YanOliveira00/Optical-Power-Meter/Photos/Tests and black box/02 Inside the box.jpg

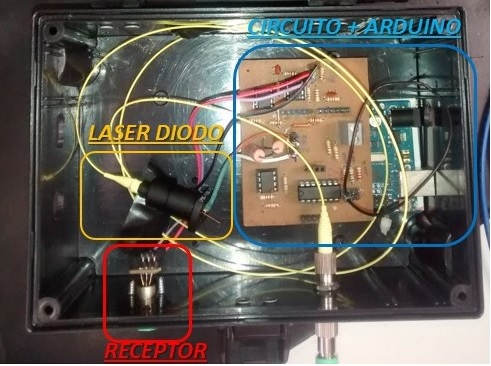
Photos/Tests and black box/02 Inside the box.jpg
