YanOliveira00/Optical-Power-Meter/Photos/Tests and black box/01 First test.jpg

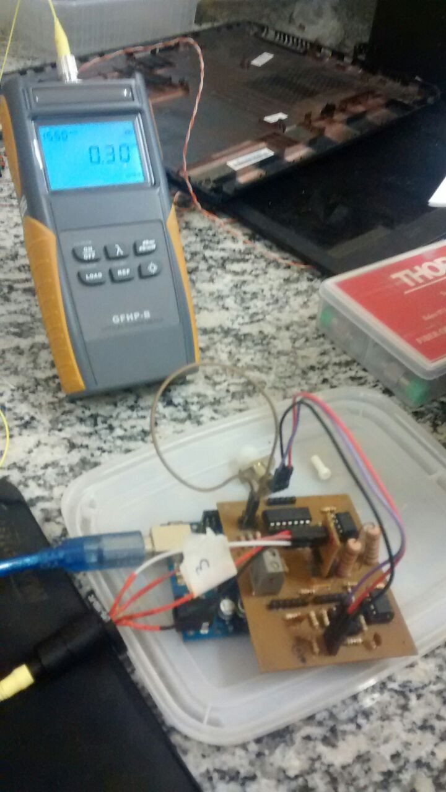
Photos/Tests and black box/01 First test.jpg
