YanOliveira00/Optical-Power-Meter/Photos/Graphics and presentation/Apresentação TCC - Yan Oliveira pdf.pdf

Universidade Federal do Pará Instituto de Tecnologia
Faculdade de Engenharia da Computação

## INTERROGADOR ÓPTICO DE BAIXO CUSTO PARA DETECÇÃO DE CURVATURA EM FIBRA ÓPTICA

Trabalho de Conclusão de Curso Orientado: Yan Sérgio de Oliveira – 201006840052 Orientador: Prof. Dr. Marco José de Sousa

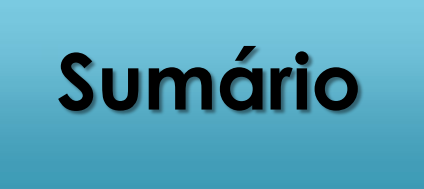
[picture p3: figure]
Sumário

1. Introdução ▪ | Monitoramento Estrutural ▪ | Sensores ópticos ▪ | Medidores ópticos ▪ | Solução proposta
2. O interrogador ▪ | Princípio operacional ▪ | Componentes externos

## 3. Circuitos

## 4. Software

## 5. Testes e resultados

## 6. Conclusões e trabalhos futuros

7. Referências.

2

# 1 – Introdução Monitoramento Estrutural (SHM – Structural Health Monitoring)

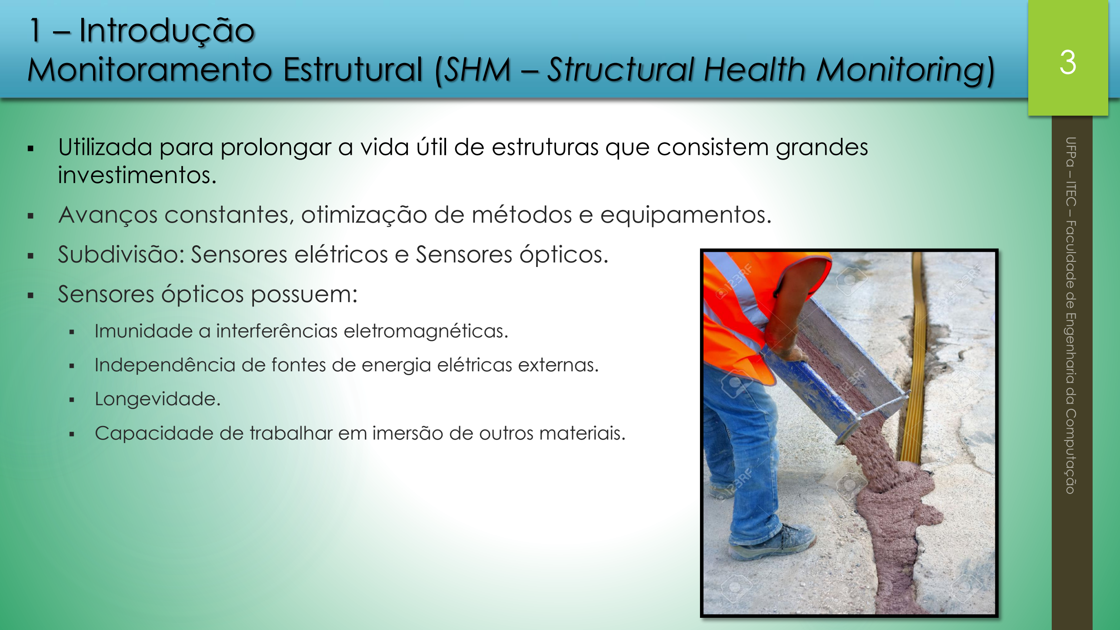
[picture p4: page 3]

## - Utilizada para prolongar a vida útil de estruturas que consistem grandes

investimentos.

- Avanços constantes, otimização de métodos e equipamentos.
- Subdivisão: Sensores elétricos e Sensores ópticos.

## - Sensores ópticos possuem:

- Imunidade a interferências eletromagnéticas.
- Independência de fontes de energia elétricas externas.
- Longevidade.
- Capacidade de trabalhar em imersão de outros materiais.

3

# 1 – Introdução Sensores Ópticos FBG (Fiber Bragg Grattings)

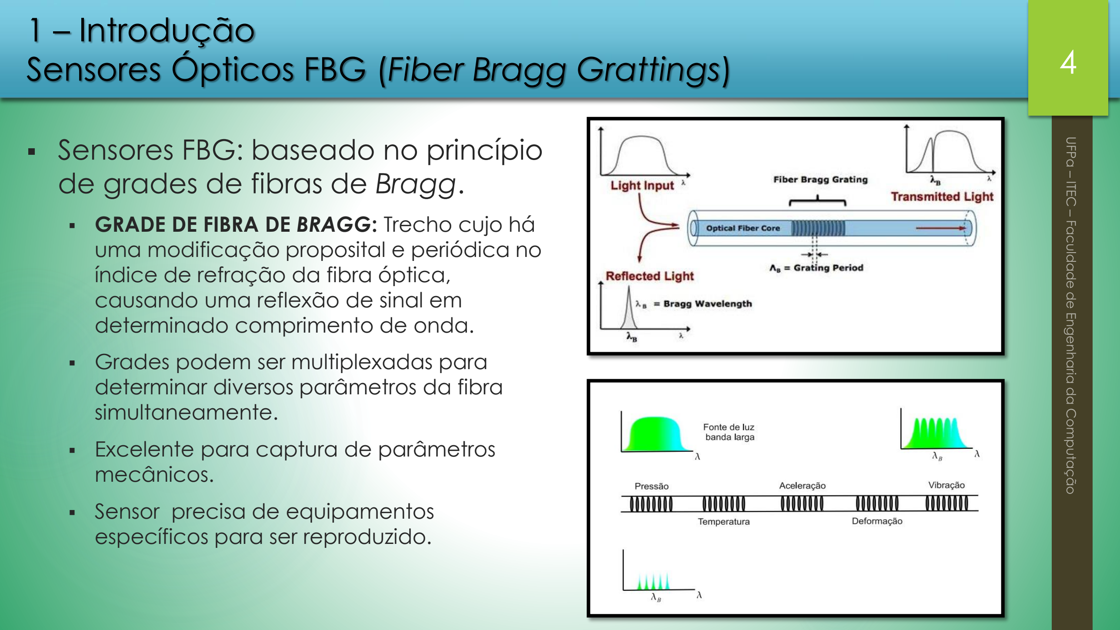
[picture p5: page 4]

## - Sensores FBG: baseado no princípio

de grades de fibras de Bragg.

- GRADE DE FIBRA DE BRAGG: Trecho cujo há uma modificação proposital e periódica no índice de refração da fibra óptica, causando uma reflexão de sinal em determinado comprimento de onda.
- Grades podem ser multiplexadas para

### determinar diversos parâmetros da fibra

simultaneamente.

- Excelente para captura de parâmetros mecânicos.

### - Sensor precisa de equipamentos

específicos para ser reproduzido.

4

# 1 – Introdução Sensores Ópticos FBG (Fiber Bragg Grattings)

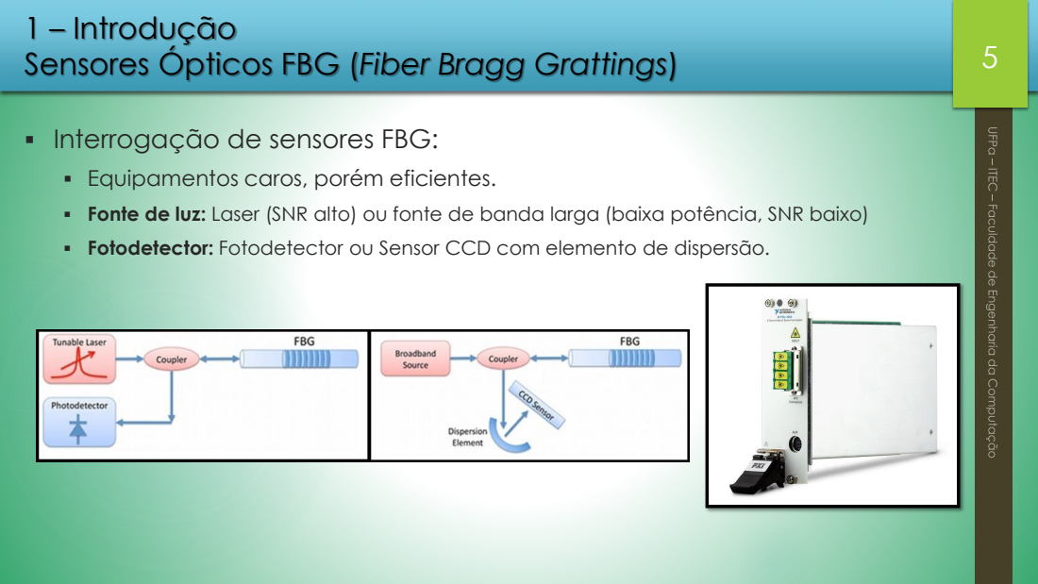
[picture p6: page 5]

▪ Interrogação de sensores FBG:

▪ Equipamentos caros, porém eficientes.

▪ Fonte de luz: Laser (SNR alto) ou fonte de banda larga (baixa potência, SNR baixo)
▪ Fotodetector: Fotodetector ou Sensor CCD com elemento de dispersão.

# 1 – Introdução Sensores SMS (Single-Multi-Single Mode)

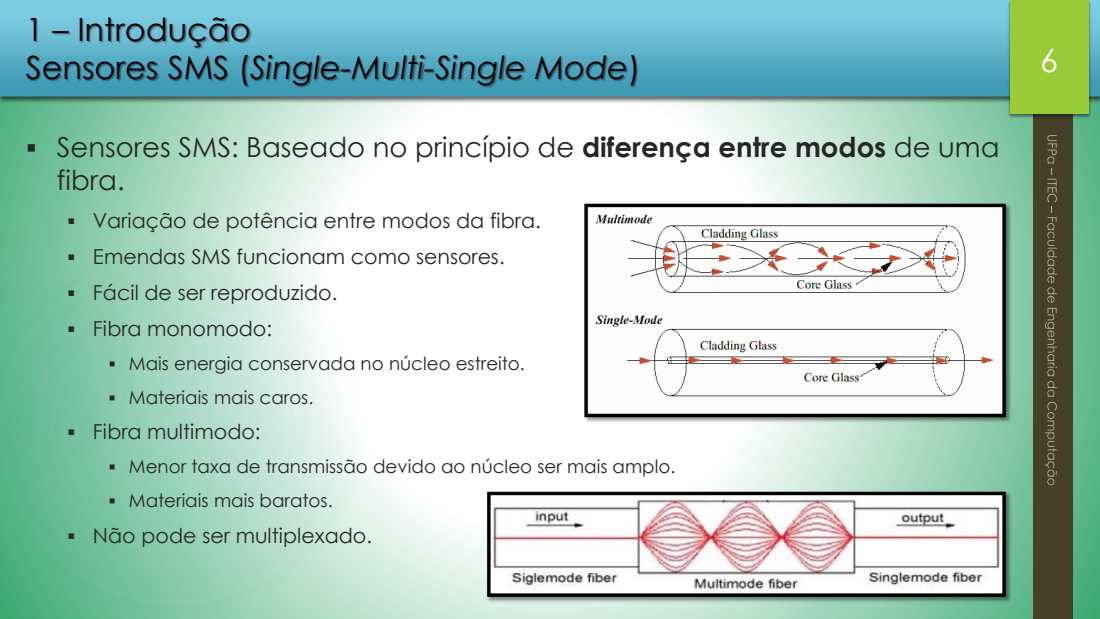
[picture p7: page 6]

▪ Sensores SMS: Baseado no princípio de diferença entre modos de uma
fibra.

▪ Variação de potência entre modos da fibra.
▪ Emendas SMS funcionam como sensores.
▪ Fácil de ser reproduzido.
▪ Fibra monomodo:

▪ Mais energia conservada no núcleo estreito.

▪ Materiais mais caros.
▪ Fibra multimodo:

▪ Menor taxa de transmissão devido ao núcleo ser mais amplo.

▪ Materiais mais baratos.
▪ Não pode ser multiplexado.

# 1 – Introdução Sensores SMS (Single-Multi-Single Mode)

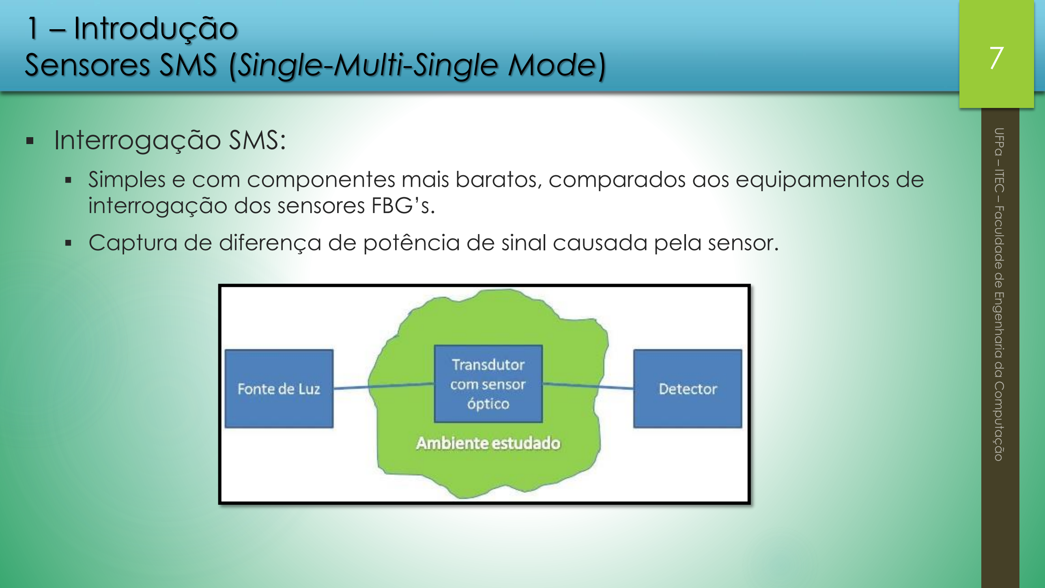
[picture p8: page 7]

## - Interrogação SMS:

## - Simples e com componentes mais baratos, comparados aos equipamentos de

interrogação dos sensores FBG’s.

- Captura de diferença de potência de sinal causada pela sensor.

7

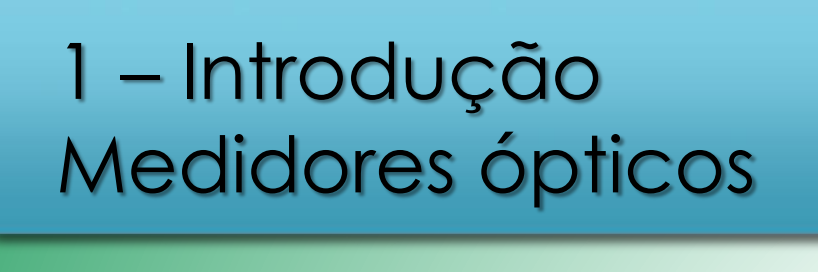
[picture p9: figure]
– Introdução

Medidores ópticos ▪ | OPM – Optical Power Meter: ▪ | Medidor de potência de sinal na fibra. ▪ | Fonte de luz ajustada a um certo nível de

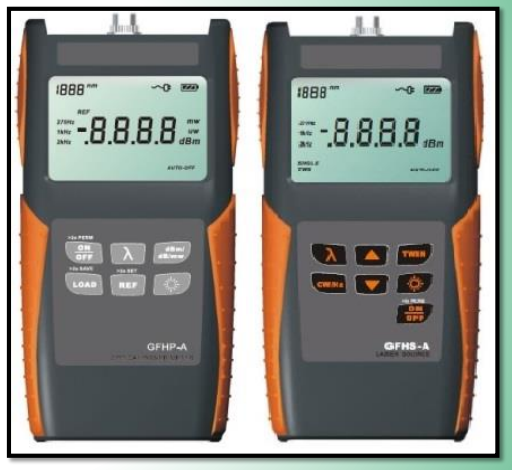
[picture p10: figure]

potência.

- | Detector com amplificador para medição ▪ | Display para visualização ▪ | Custa em torno de R$ 2.745,00. Pode sofrer

acréscimos nesse valor.

- | Podem possuir outras funções práticas: ▪ | Medidor de luminosidade. ▪ | Fotômetro.

8

1

# – Introdução

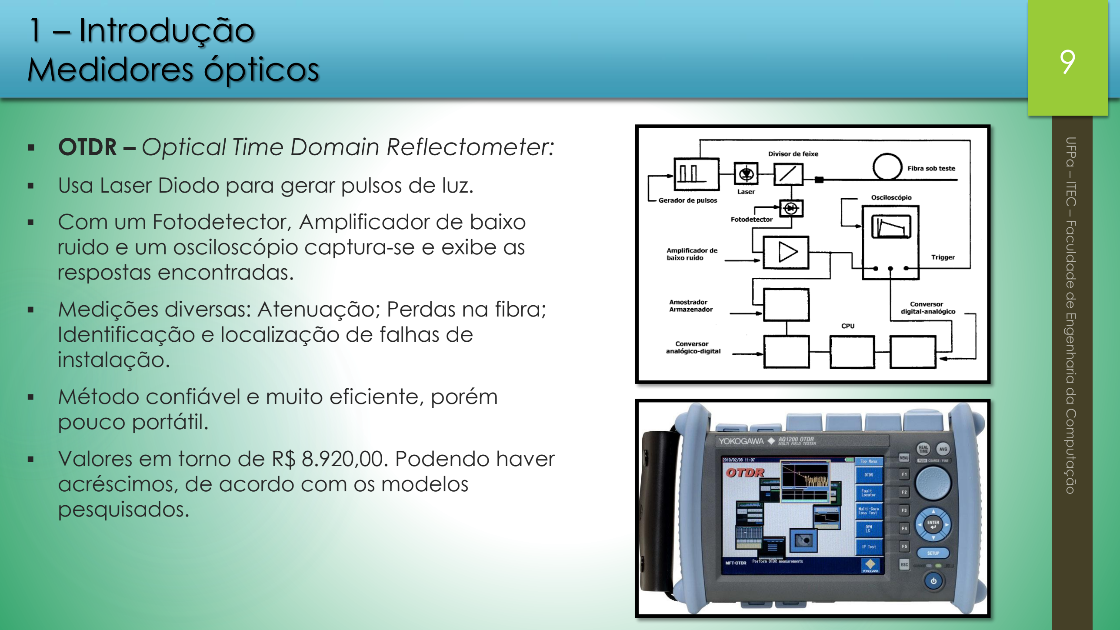
[picture p11: page 9]

## Medidores ópticos ▪ OTDR – Optical Time Domain Reflectometer

:

- Usa Laser Diodo para gerar pulsos de luz

- Com um Fotodetector, Amplificador de baixo ruido e um osciloscópio captura
-se e exibe as
respostas encontradas.
- Medições diversas: Atenuação; Perdas na fibra; Identificação e localização de falhas de instalação

### - Método confiável e muito eficiente, porém

pouco portátil
- Valores em torno de R$ 8.920,00. Podendo haver acréscimos, de acordo com os modelos

### pesquisados

9

# 1 – Introdução Proposta

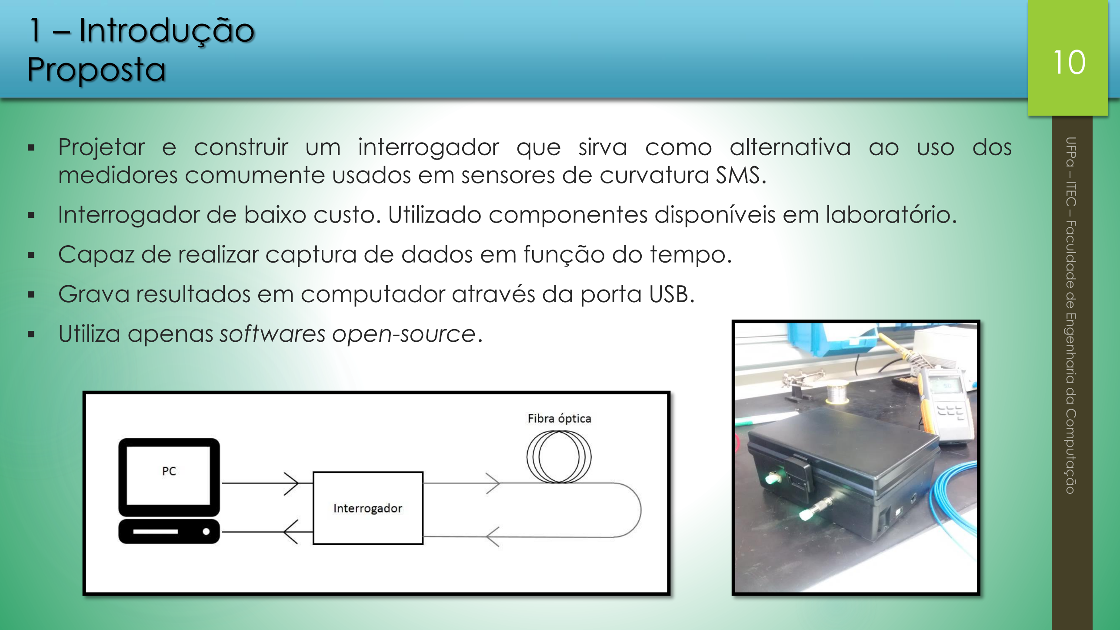
[picture p12: page 10]

## - Projetar e construir um interrogador que sirva como alternativa ao uso dos

medidores comumente usados em sensores de curvatura SMS.

- Interrogador de baixo custo. Utilizado componentes disponíveis em laboratório.
- Capaz de realizar captura de dados em função do tempo.
- Grava resultados em computador através da porta USB.
- Utiliza apenas softwares open-source.

10

# 2. O interrogador Princípio Operacional

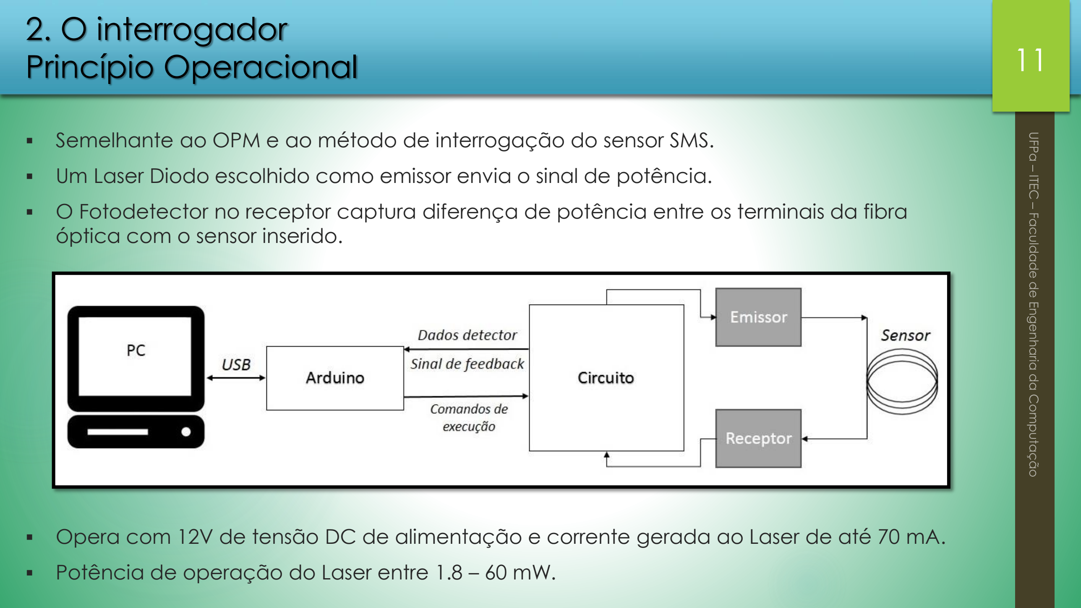
[picture p13: page 11]

- Semelhante ao OPM e ao método de interrogação do sensor SMS.
- Um Laser Diodo escolhido como emissor envia o sinal de potência.
- O Fotodetector no receptor captura diferença de potência entre os terminais da fibra óptica com o sensor inserido.
- Opera com 12V de tensão DC de alimentação e corrente gerada ao Laser de até 70 mA.
- Potência de operação do Laser entre 1.8 – 60 mW.

11

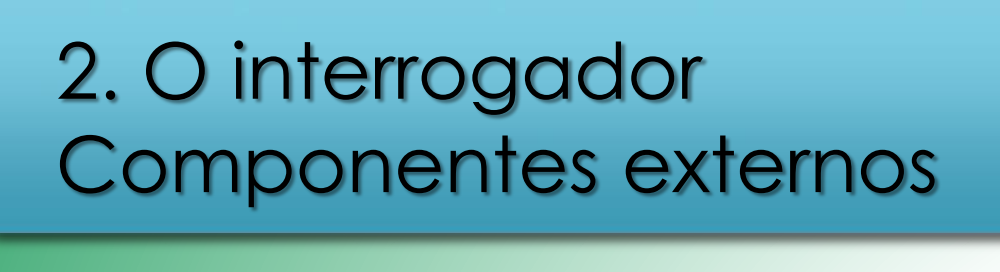
[picture p14: figure]
2. O interrogador Componentes externos

## - O interrogador é formado pelos seguintes componentes:

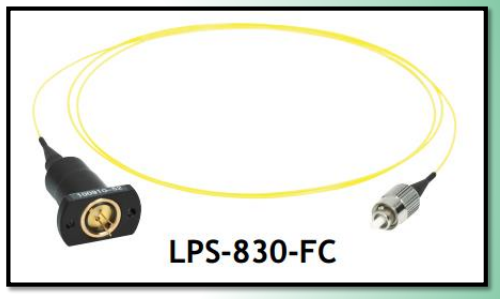
[picture p15: figure]

## - SBC ArduinoUno®

## - Laser Diodos:

- Modelos disponíveis: LP, LPM, LPS, LPSC.
- Comprimentos de onda: 660-1550 nm
- Potência Máxima: 60 mW

## - Fotodetector:

- Modelo: FGA01FC

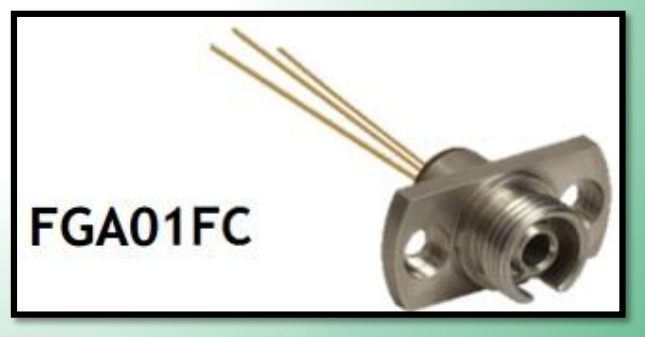
[picture p16: figure]

- Comprimentos de onda: 800-1770 nm

### - Potência Máxima: 18 mW

12

# 3. Circuitos

13

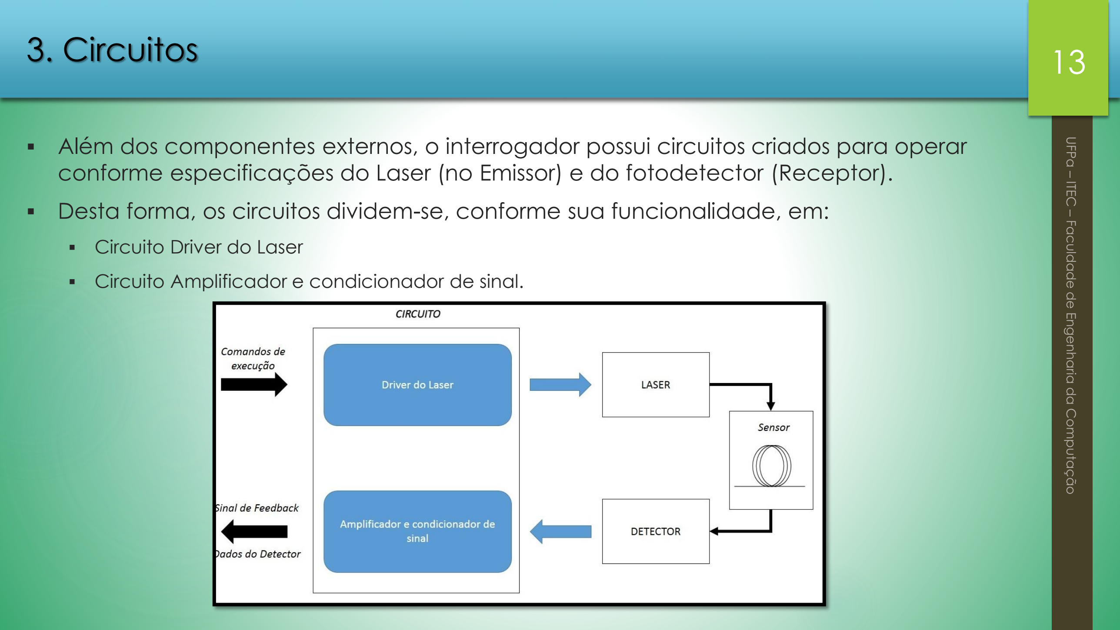
[picture p17: page 13]

### - Além dos componentes externos, o interrogador possui circuitos criados para operar

conforme especificações do Laser (no Emissor) e do fotodetector (Receptor).

### - Desta forma, os circuitos dividem-se, conforme sua funcionalidade, em:

- Circuito Driver do Laser
- Circuito Amplificador e condicionador de sinal.

# 3. Circuitos

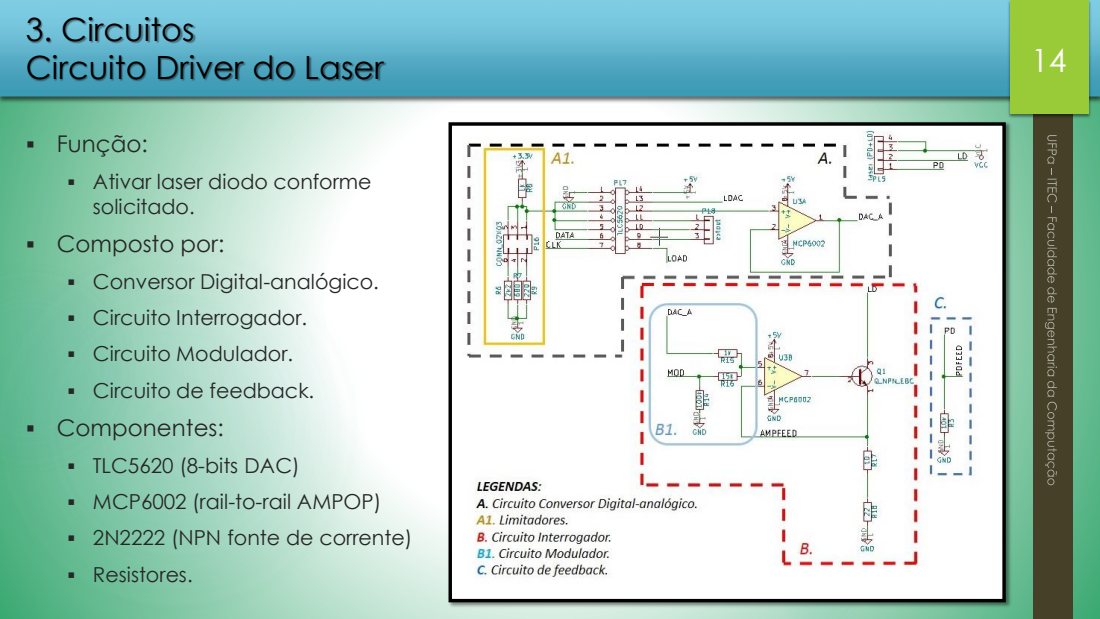
[picture p18: page 14]
Circuito Driver do Laser; Função: ▪; Ativar laser diodo conforme; solicitado.; Composto por: ▪; Conversor Digital; -analógico.; Circuito Interrogador. ▪; Circuito Modulador. ▪; Circuito de feedback.; Componentes: ▪; TLC5620 (8-bits DAC) ▪; MCP6002 (rail-to-rail AMPOP) ▪; 2N2222 (NPN fonte de corrente) ▪; Resistores.

# 3. Circuitos

Circuito Amplificador e Condicionador de Sinal.

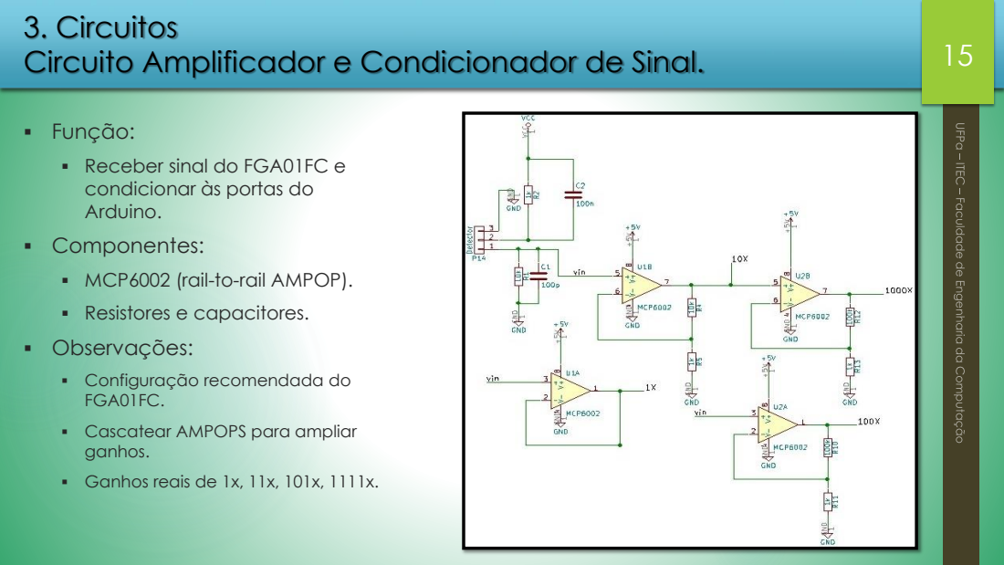
[picture p19: page 15]
▪ Função:; ▪ Componentes:

▪ Receber sinal do FGA01FC e
condicionar às portas do
Arduino.

▪ MCP6002 (rail-to-rail AMPOP).
▪ Resistores e capacitores.
▪ Observações:

▪ Configuração recomendada do
FGA01FC.
▪ Cascatear AMPOPS para ampliar
ganhos.
▪ Ganhos reais de 1x, 11x, 101x, 1111x.

3. Circuitos.
Esquemático Completo. | 16

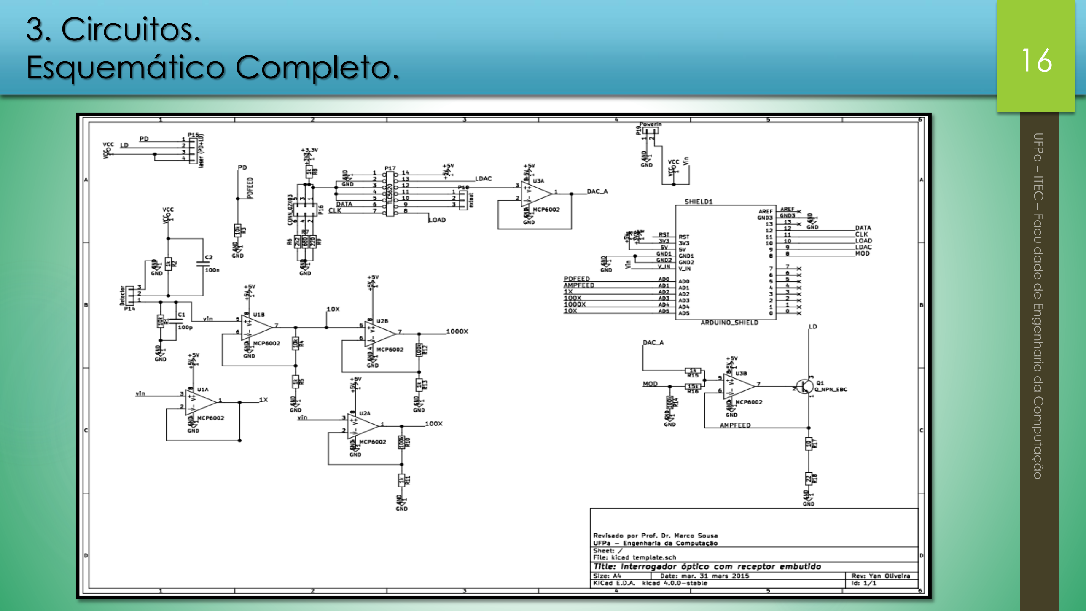
[picture p20: page 16]

3. Circuitos.
Footprint e placa | 17

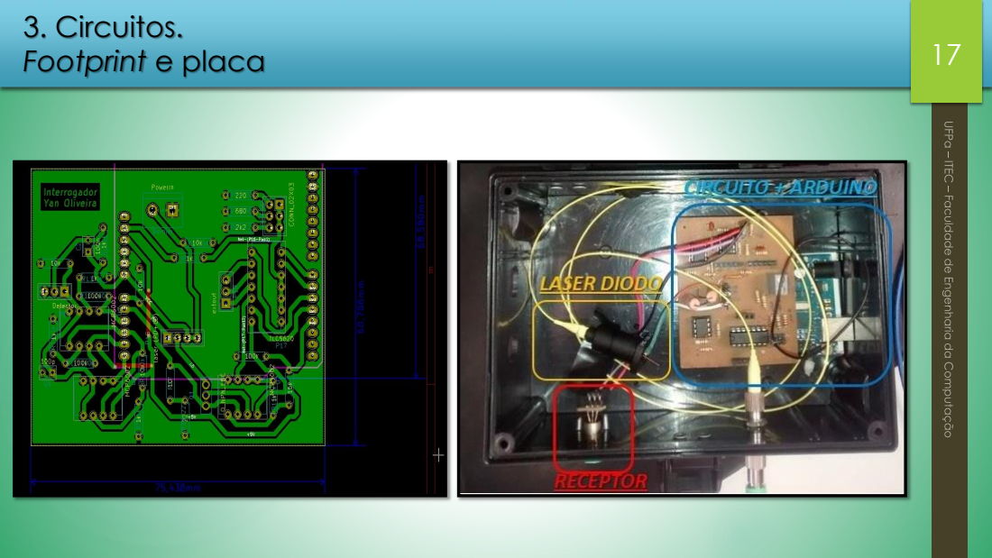
[picture p21: page 17]

# 4. Software

18

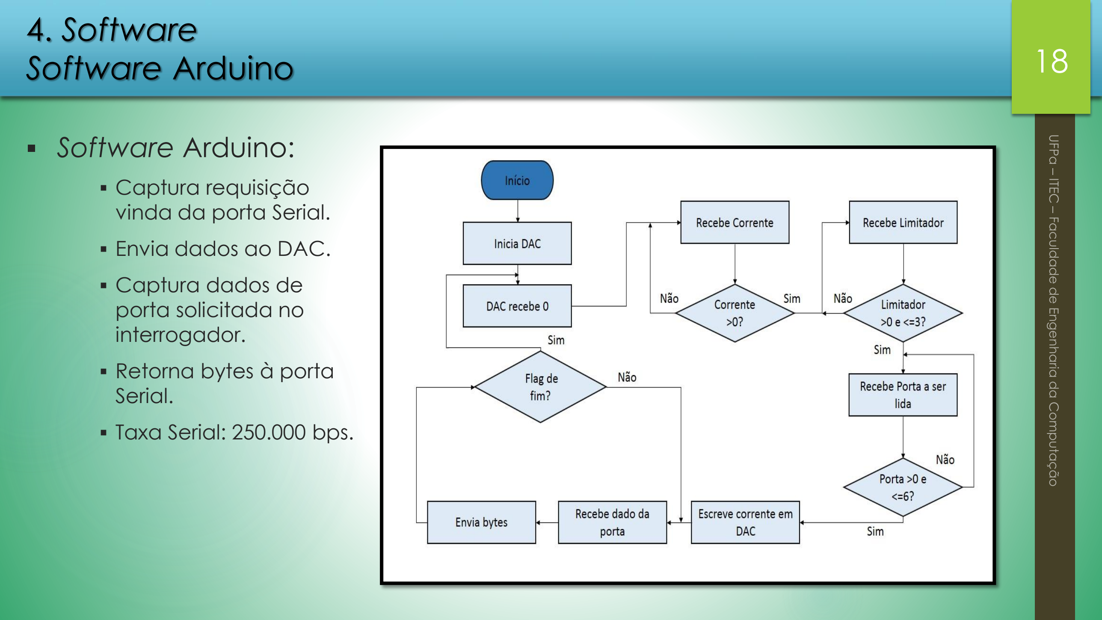
[picture p22: page 18]

Software Arduino ▪ Software Arduino: ▪ Captura requisição

vinda da porta Serial.

- Envia dados ao DAC. ▪ Captura dados de

porta solicitada no
interrogador.
- Retorna bytes à porta
Serial

- Taxa Serial: 250.000 bps

# 4. Software Software Python

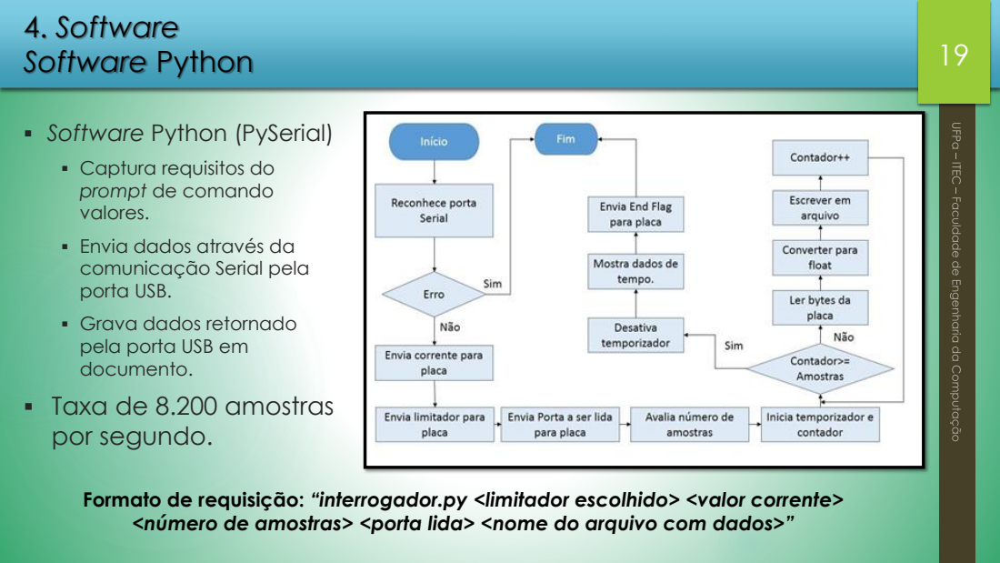
[picture p23: page 19]

▪ Software Python (PySerial)

▪ Captura requisitos do
prompt de comando
valores.
▪ Envia dados através da
comunicação Serial pela
porta USB.
▪ Grava dados retornado
pela porta USB em
documento.
▪ Taxa de 8.200 amostras
por segundo.

Formato de requisição: “interrogador.py <limitador escolhido> <valor corrente>
<número de amostras> <porta lida> <nome do arquivo com dados>”

5- Resultados e testes.

## - Valor final do interrogador: R$ 2.355,00

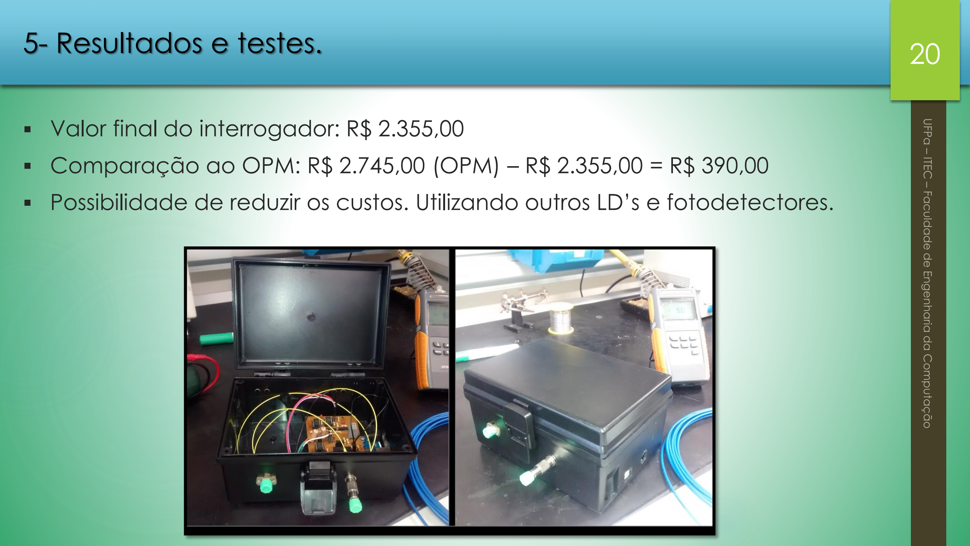
[picture p24: page 20]

## - Comparação ao OPM: R$ 2.745,00 (OPM) – R$ 2.355,00 = R$ 390,00

- Possibilidade de reduzir os custos. Utilizando outros LD’s e fotodetectores.

20

5- Resultados e testes.

## - Os testes dividem-se da seguinte forma:

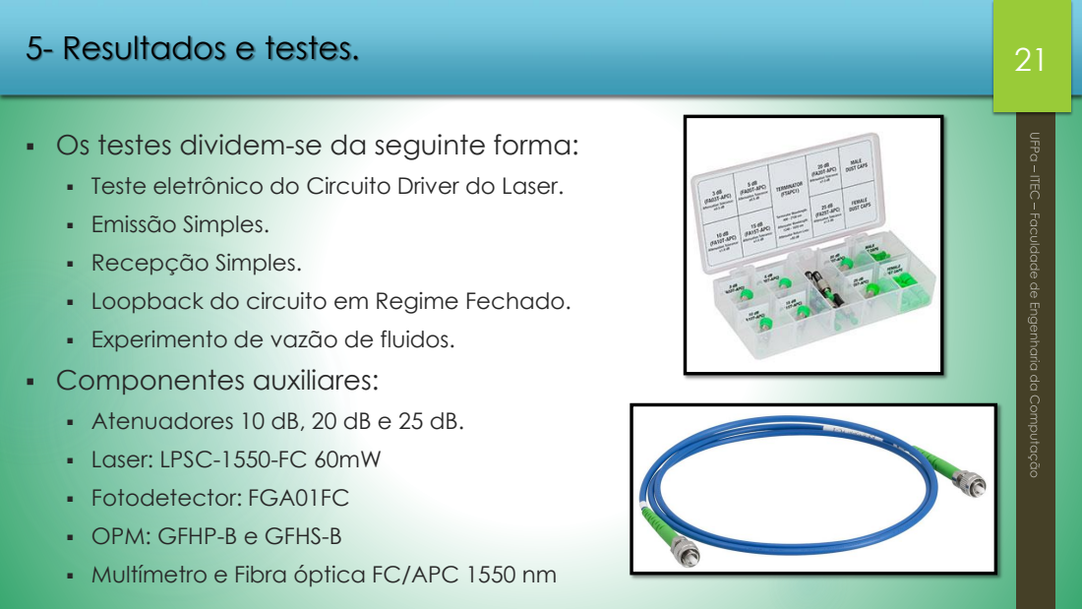
[picture p25: page 21]

▪ Teste eletrônico do Circuito Driver do Laser.
▪ Emissão Simples.
▪ Recepção Simples.
▪ Loopback do circuito em Regime Fechado.
▪ Experimento de vazão de fluidos.
▪ Componentes auxiliares:

▪ Atenuadores 10 dB, 20 dB e 25 dB.
▪ Laser: LPSC-1550-FC 60mW
▪ Fotodetector: FGA01FC
▪ OPM: GFHP-B e GFHS-B
▪ Multímetro e Fibra óptica FC/APC 1550 nm

# 5- Resultados e testes Teste Eletrônico do Circuito Driver do Laser

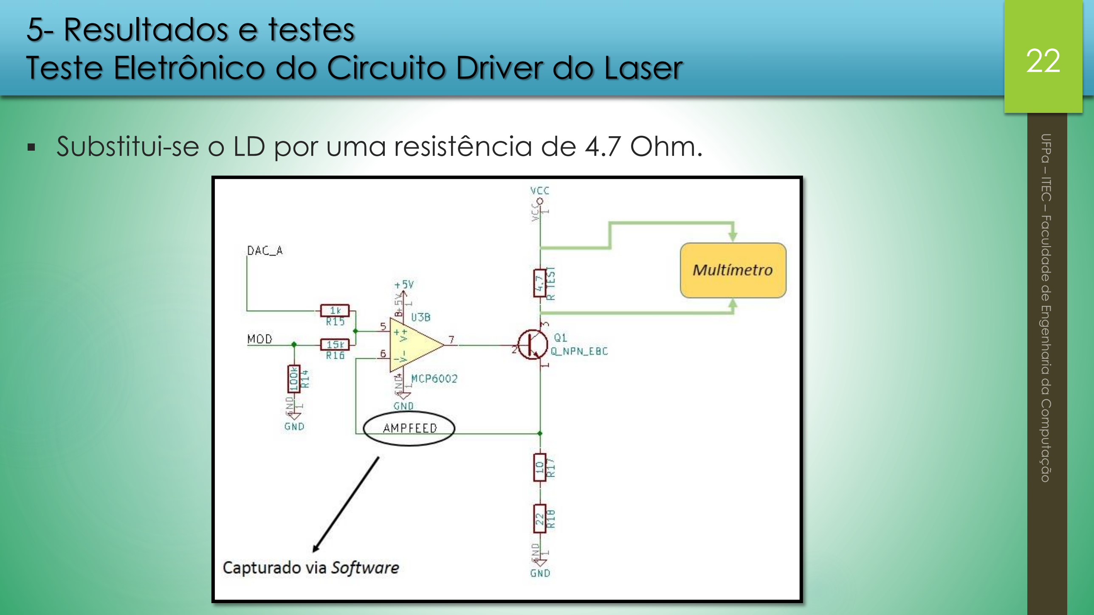
[picture p26: page 22]

- Substitui-se o LD por uma resistência de 4.7 Ohm.

22

# 5- Resultados e testes Teste Eletrônico do Circuito Driver do Laser

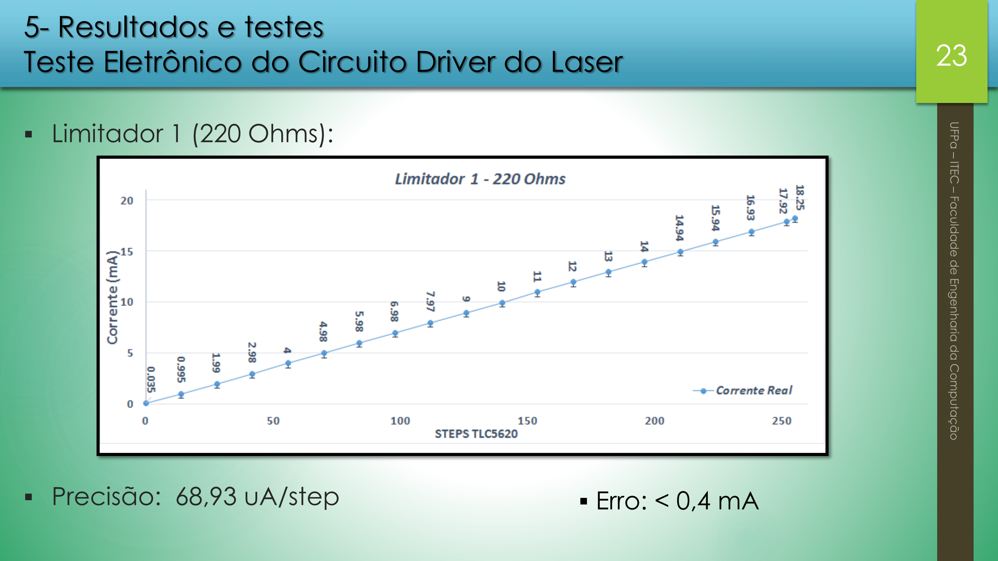
[picture p27: page 23]

## - Limitador 1 (220 Ohms):

## - Precisão: 68,93 uA/step

23

## - Erro: < 0,4 mA

# 5- Resultados e testes Teste Eletrônico do Circuito Driver do Laser

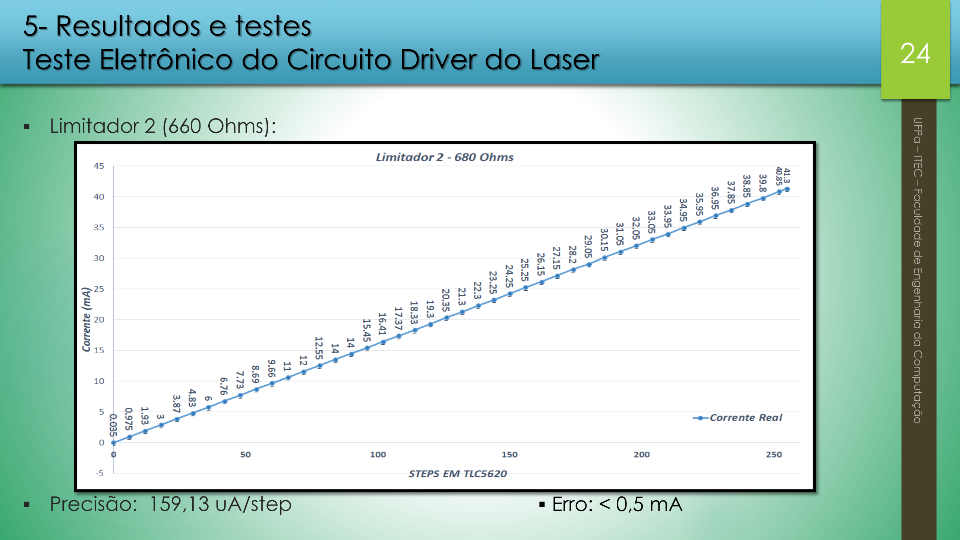
[picture p28: page 24]

## - Limitador 2 (660 Ohms):

## - Precisão: 159,13 uA/step

24

## - Erro: < 0,5 mA

# 5- Resultados e testes Teste Eletrônico do Circuito Driver do Laser

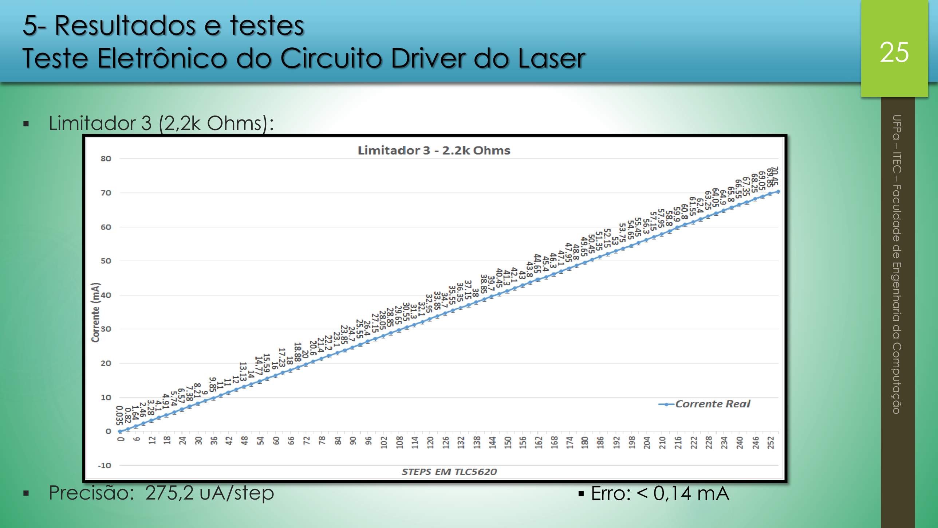
[picture p29: page 25]

## - Limitador 3 (2,2k Ohms):

## - Precisão: 275,2 uA/step

25

## - Erro: < 0,14 mA

5

# - Resultados e testes

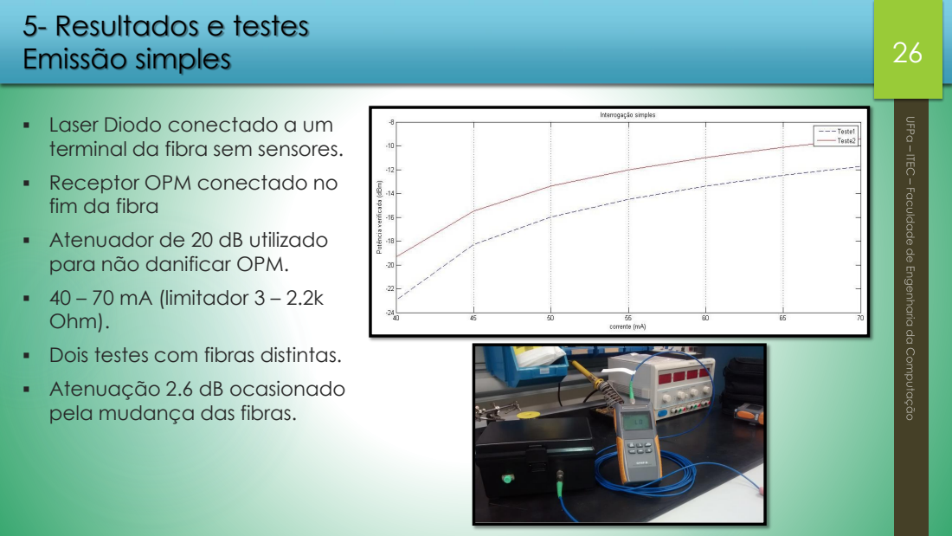
[picture p30: page 26]
Emissão simples ▪; Laser Diodo conectado a um; – 70 mA (limitador 3; Dois testes com fibras distintas. ▪; Atenuação 2.6 dB ocasionado

terminal da fibra sem sensores.
▪ Receptor OPM conectado no
fim da fibra
▪ Atenuador de 20 dB utilizado
para não danificar OPM.
Ohm).

pela mudança das fibras.

5

# - Resultados e testes

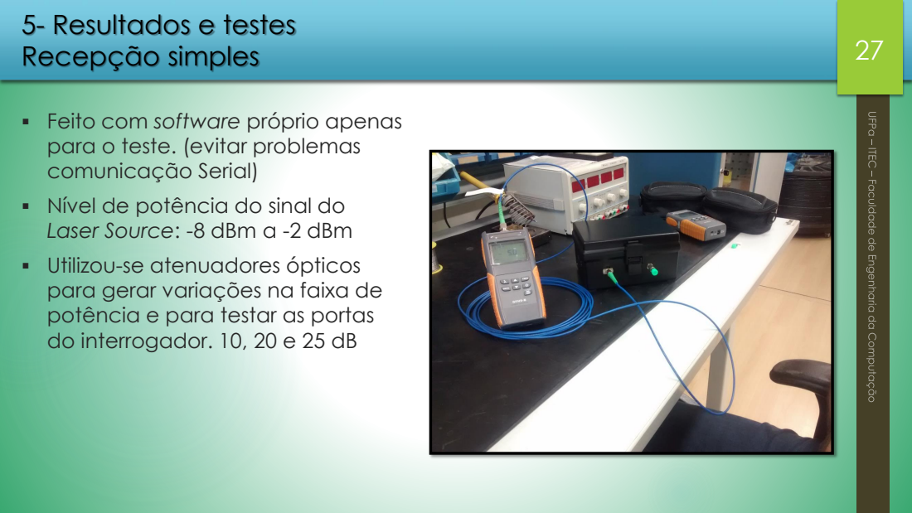
[picture p31: page 27]
Recepção simples ▪; Feito com software próprio apenas; -8 dBm a; -2 dBm

para o teste. (evitar problemas
comunicação Serial)
▪ Nível de potência do sinal do
Laser Source:
▪ Utilizou
para gerar variações na faixa de
potência e para testar as portas
do interrogador. 10, 20 e 25 dB

-se atenuadores ópticos

5

# - Resultados e testes

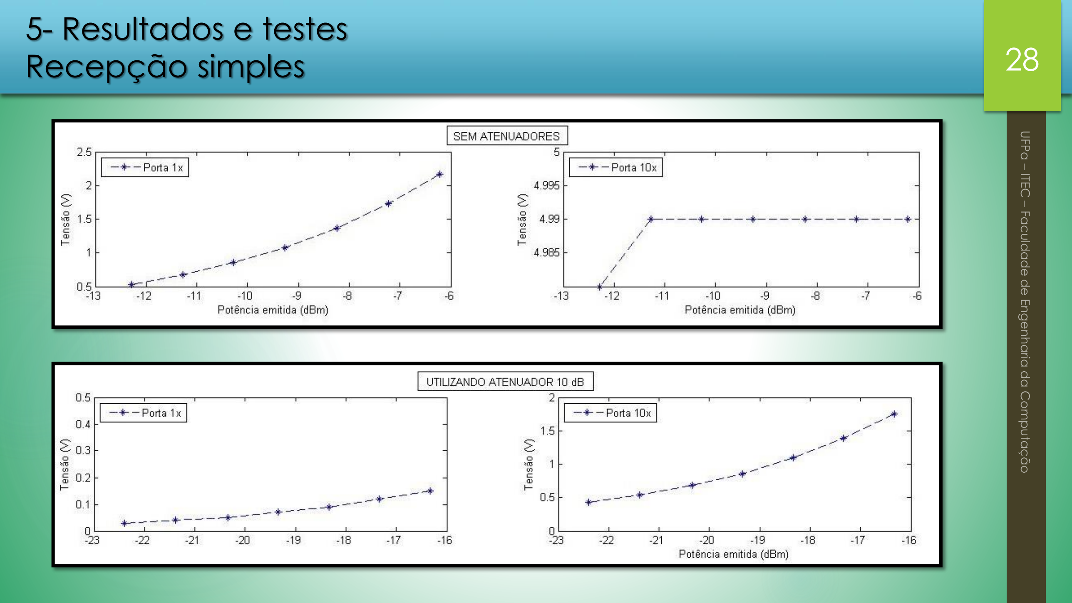
[picture p32: page 28]

Recepção simples | 28

5

# - Resultados e testes

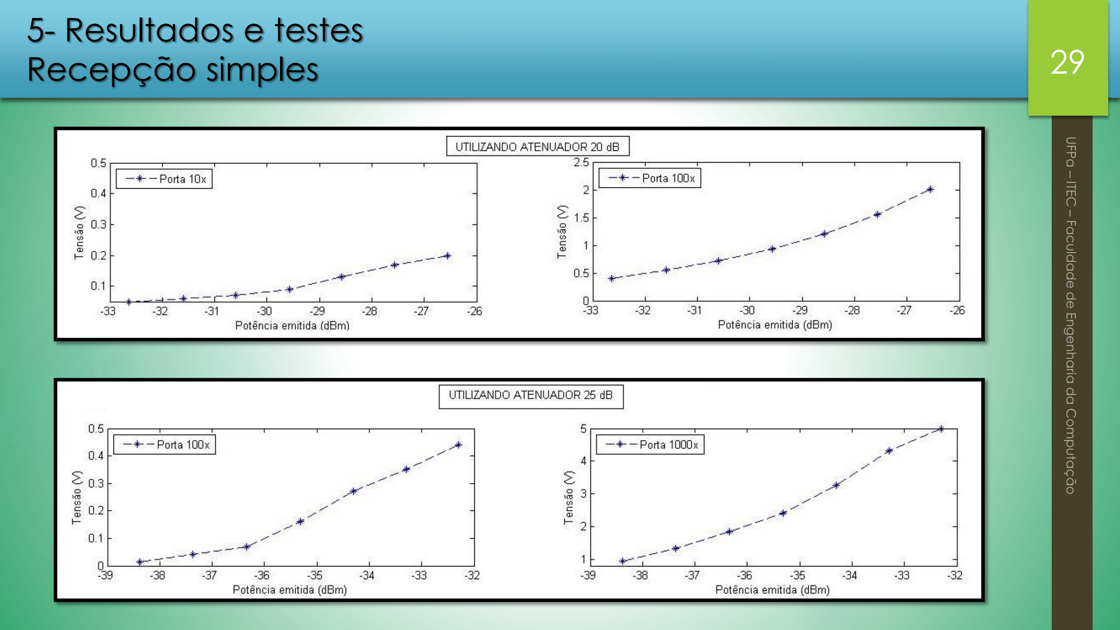
[picture p33: page 29]

Recepção simples | 29

# 5- Resultados e testes Recepção simples

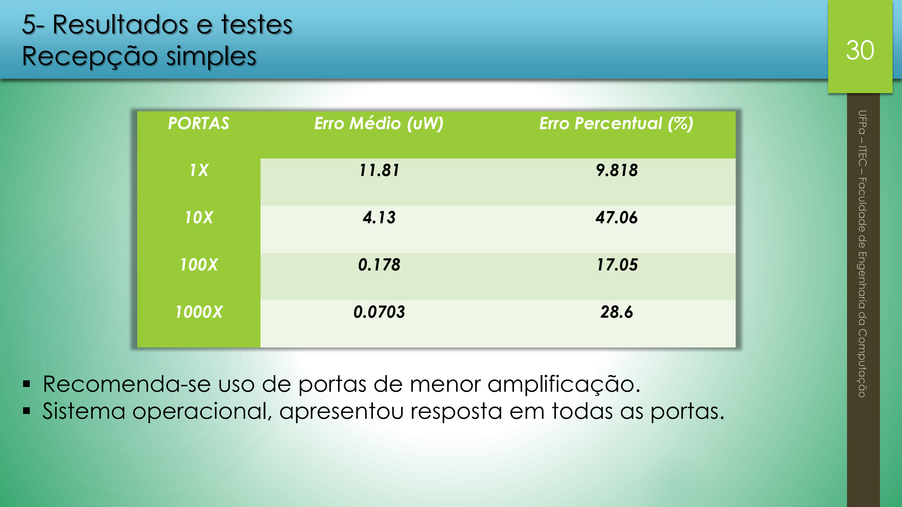
[picture p34: page 30]

PORTAS | Erro Médio (uW) | Erro Percentual (%)
1X | 11.81 | 9.818
10X | 4.13 | 47.06
100X | 0.178 | 17.05
1000X | 0.0703 | 28.6

30

- Recomenda-se uso de portas de menor amplificação.
- Sistema operacional, apresentou resposta em todas as portas.

# 5- Resultados e testes

Teste de loopback do Circuito.

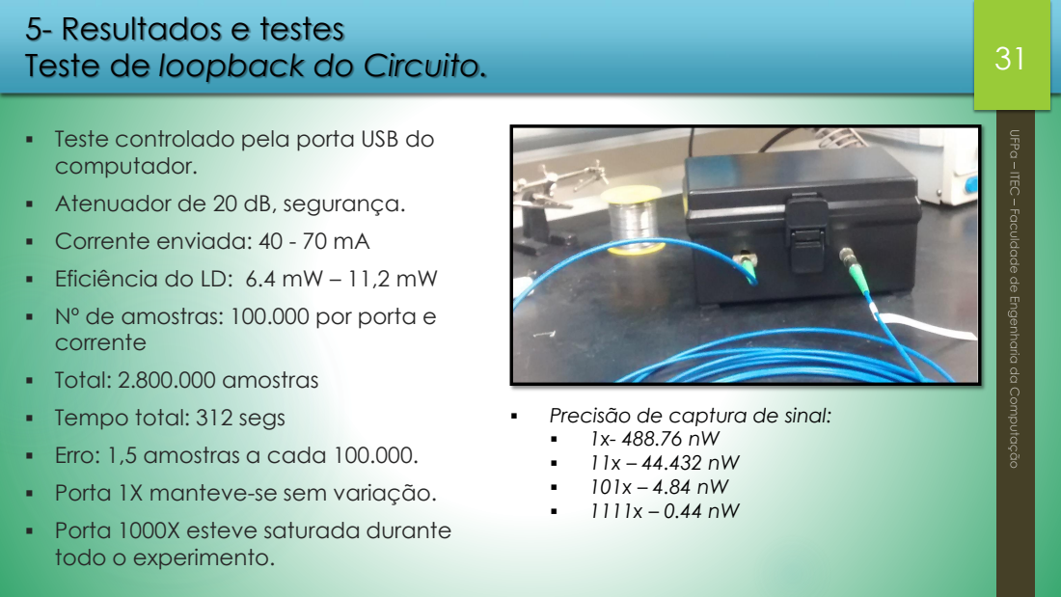
[picture p35: page 31]

▪ Teste controlado pela porta USB do
computador.
▪ Atenuador de 20 dB, segurança.
▪ Corrente enviada: 40 - 70 mA
▪ Eficiência do LD: 6.4 mW – 11,2 mW
▪ Nº de amostras: 100.000 por porta e
corrente
▪ Total: 2.800.000 amostras
▪ Tempo total: 312 segs
▪ Erro: 1,5 amostras a cada 100.000.
▪ Porta 1X manteve-se sem variação.
▪ Porta 1000X esteve saturada durante
todo o experimento.

▪ Precisão de captura de sinal:

5

# - Resultados e testes

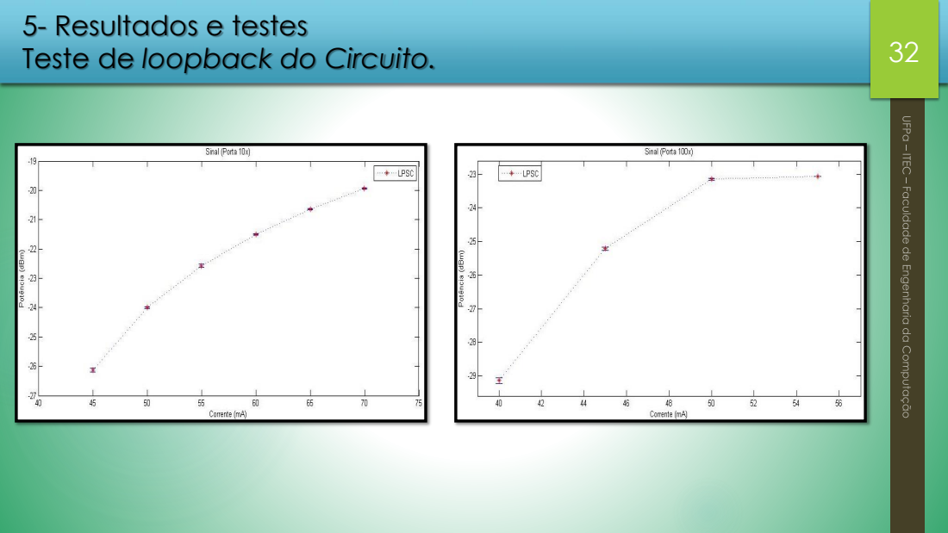
[picture p36: page 32]
Teste de loopback do Circuito.

5

# - Resultados e testes

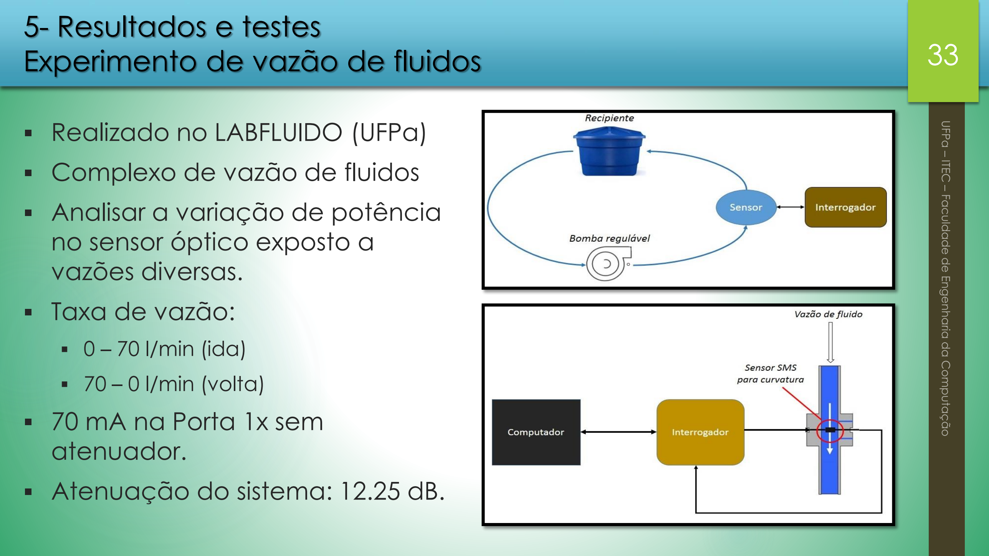
[picture p37: page 33]

Experimento de vazão de fluidos ▪ | Realizado no LABFLUIDO (UFPa) ▪ | Complexo de vazão de fluidos ▪ | Analisar a variação de potência

## no sensor óptico exposto a

vazões diversas.

- | Taxa de vazão: ▪ | 0 – 70 l/min (ida) ▪ | 70 – 0 l/min (volta

)

## - 70 mA na Porta 1x sem

atenuador.
- Atenuação do sistema: 12.25 dB.

33

5

# - Resultados e testes

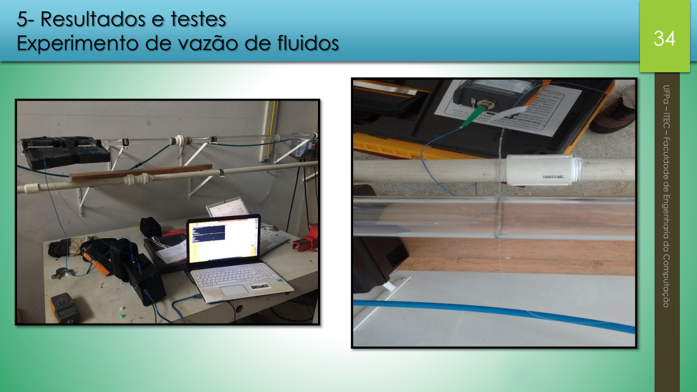
[picture p38: page 34]
Experimento de vazão de fluidos

# 5- Resultados e testes

Experimento de vazão de fluidos | 35

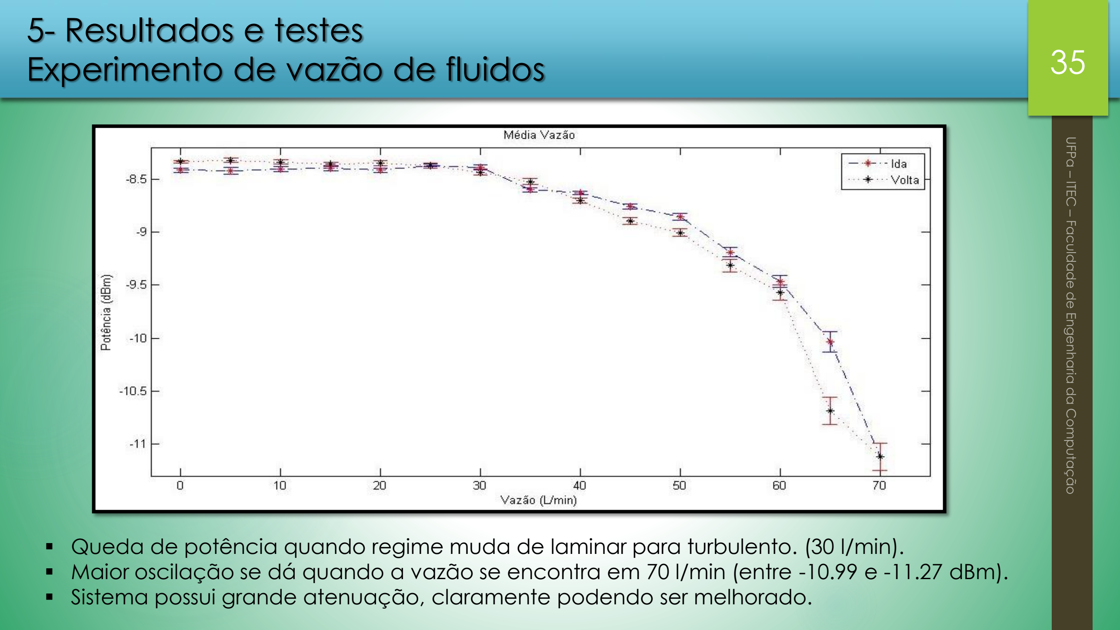
[picture p39: page 35]

- Queda de potência quando regime muda de laminar para turbulento. (30 l/min).
- Maior oscilação se dá quando a vazão se encontra em 70 l/min (entre -10.99 e -11.27 dBm).
- Sistema possui grande atenuação, claramente podendo ser melhorado.

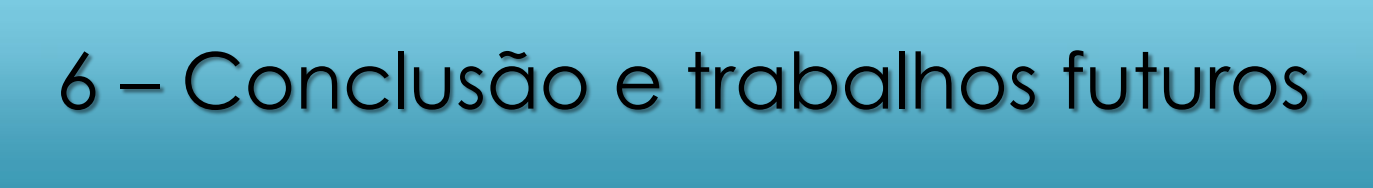
[picture p40: figure]
6 – Conclusão e trabalhos futuros

- Interrogador se encontra operacional.
- Otimizar o interrogador para torna-lo comerciável.

## - Problemas encontrados:

- Instabilidade da ferramenta PySerial.
- Código não é multiplataforma.

## - Implementar todos os circuitos. (Circuito Modulador, p.e.)

## - Trabalhos futuros:

- Tornar interrogador autônomo, com implante de leitura de cartão SD, incremento de bateria e display.
- Automatizar o reconhecimento do limitador, evitando possíveis falhas humanas.
- Melhorar a segurança de código.
- Otimizar custos com componentes.

36

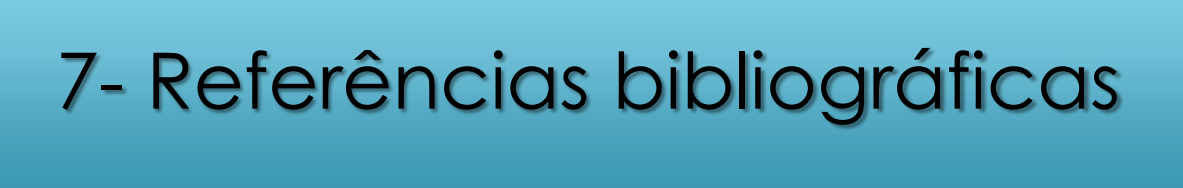
[picture p41: figure]
7- Referências bibliográficas

- ABADDE & CAMPOS - ABADDE, André L. R. CAMPOS, Maria Regina. Aplicação do OTDR na Análise de Problemas de Atenuação em Fibras Ópticas: Estudo de casos. REVISTA Científica Periódica – Telecomunicações ISSN 1513-2338. Telecom Volume 06 – nº 02 12/2002
- AGRAWAL, Govind. Fiber-optic communication systems. 3° ed. 2002 Seção: 1.4.2.
- BALLOD, Yanes Checcacci. Dispositivos à fibra óptica baseados em interferência multimodal (MMI) para telecomunicações e sensoriamento. Dissertação (Mestrado em Engenharia de Telecomunicações) - PGET -Universidade federal Fluminense. Niterói, RJ. 2011.
- DOS SANTOS, Adam Dreyton Ferreira. Desenvolvimento de sistema de persistência para redes de sensores ópticos. Monografia (Engenharia da Computação) – ITEC- Universidade Federal do Pará. Belém-Pa. 2013.
- DUARTE & CARVALHO - DUARTE, Lucas. CARVALHO, Henrique. INSTRUMENTAÇÃO PARA ENSINO.http://www.ifi.unicamp.br/~lunazzi/F530_F590_F690_F809_F895/F809/F809_sem1_2003/002013Lucasm-Carvalho_F809_RF10_0.pdf Acessado em : 17/01/2016. (http://www.ifi.unicamp.br/~lunazzi/F530_F590_F690_F809_F895/F809/F809_sem1_2003/002013Lucasm-Carvalho_F809_RF10_0.pdf)
- FERNANDES, Cindy Stella. DESENVOLVIMENTO DE SENSORES BASEADOS EM FIBRA ÓPTICA PARA MONITORAMENTO ESTRUTURAL. Tese (Doutorado em Engenharia Elétrica)-PPGEE-UFPa. Belém, 2016.
- FS.COM. Five Basics About Fiber Optic Cables. Disponível em: http://www.fiber-optic-equipment.com/tag/multimode-fiber. Visto em: 20/03/2016. (http://www.fiber-optic-equipment.com/tag/multimode-fiber)
- GARRET, Kellis. How optical sensing solves the toughest sensing challenges. NI -November 01, 2012. Disponível em: http://www.edn.com/design/test-and-measurement/4400423/How-optical-sensing-solves-the-toughest-sensing-challenges. visto em 19/01/2017 às 17:30. (http://www.edn.com/design/test-and-measurement/4400423/How-optical-sensing-solves-the-toughest-sensing-challenges)

37

- HBM [2]. O que é um sensor FBG? (FIBER BRAGG GRATING). Disponível em: http://www.hbm.com/pt/4596/dicas-e-informacoes-o-que-e-sensor-fbg/ Acessado em 19/01/2016.
- HBM. Introdução HBM monitoramento estrutural. Disponível em: https://www.hbm.com/pt/5530/monitoramento-estrutural/ Acessado em: 02/01/2017. (https://www.hbm.com/pt/5530/monitoramento-estrutural/)
- LOUZADA, Daniel Ramos. Detecção e caracterização de danos estruturais através de sensores a rede de Bragg e Redes Neurais Artificiais - Tese (doutorado) – Pontifícia Universidade Católica do Rio de Janeiro, Departamento de Engenharia Mecânica, 2013.
- MEJIA & BASURTO. A.R. Mejia-Aranda, M.A. Basurto-Pensado, E.E. Antunez-Ceron. Fiber Optic Pressure Sensor of 0–0.36 psi by Multimode Interference Technique. Journal of Applied Research and Technology. JART. Vol 11 Núm
5. Oct/2013.
- NATIONAL INSTRUMENTS. Fundamentos de detecção óptica (FBG). Disponível em: http://www.ni.com/white-paper/11821/en/ Escrito em: 01/2016. Visto em: 09/01/2017. (http://www.ni.com/white-paper/11821/en/)
- ROBERTSON, Bruce. KINGFISHER International Application Notes. Disponível em: https://www.kingfisherfiber.com/Application-Notes.aspx Acessado em: 15/01/2016.
- SOUSA. Marco J. Síntese de grades de Bragg em fibra: técnicas de aceleração e codificação para algoritmos evolucionários. PhD thesis, Universidade Federal do Pará, Belém-Pa. Feb, 2008.

38

# Obrigado pela atenção!

39
