YanOliveira00/Optical-Power-Meter/Codes/Arduino/Fluxograma Arduino.JPG

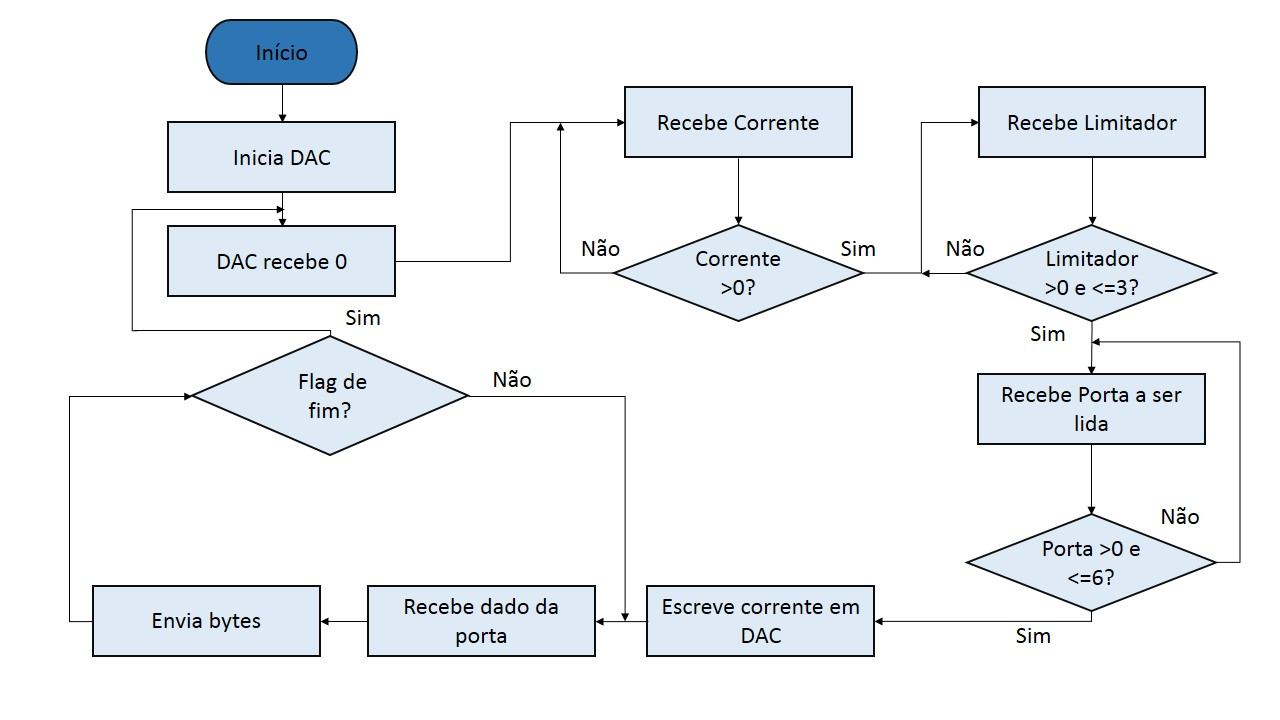
Codes/Arduino/Fluxograma Arduino.JPG
