YanOliveira00/Optical-Power-Meter/Codes/Python/FluxoGrama Py.JPG

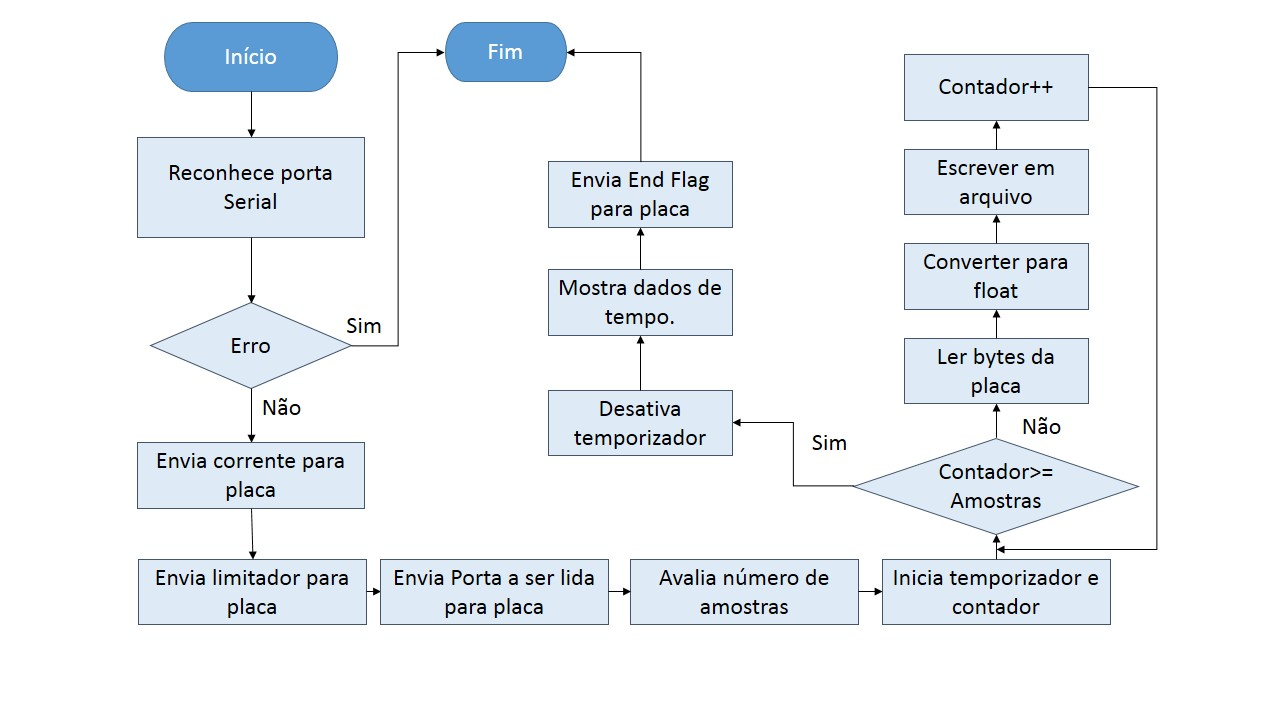
Codes/Python/FluxoGrama Py.JPG
