YanOliveira00/Optical-Power-Meter/Photos/Graphics and presentation/2k2 Ohm current range.jpg

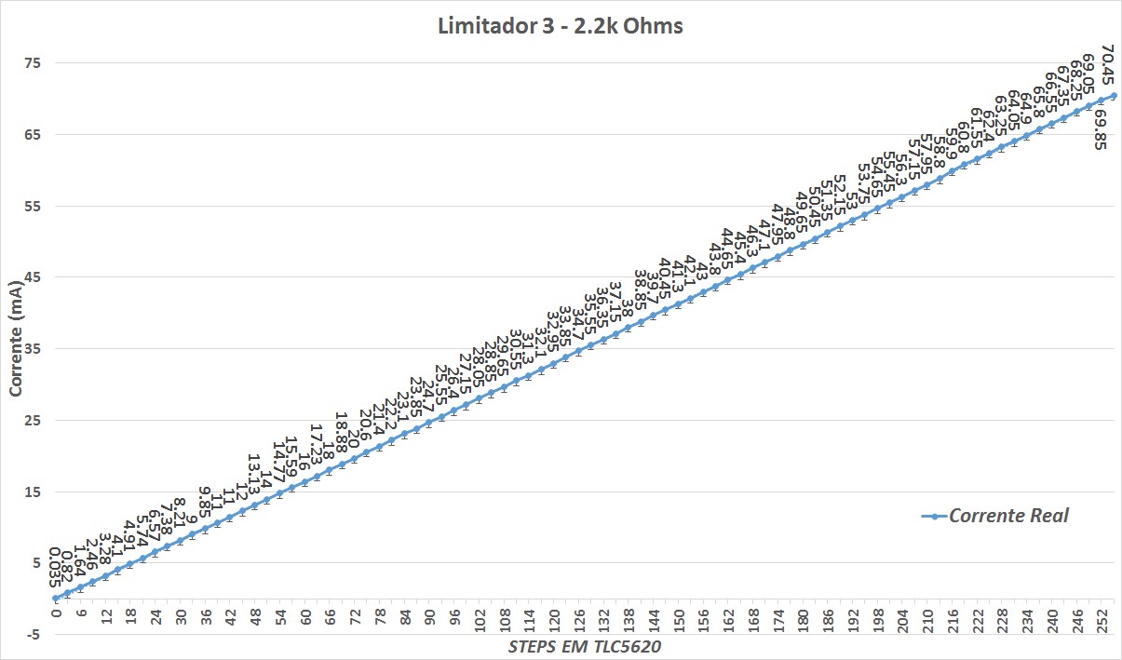
Photos/Graphics and presentation/2k2 Ohm current range.jpg
