YanOliveira00/Optical-Power-Meter/Photos/Graphics and presentation/220OHm current range.jpg

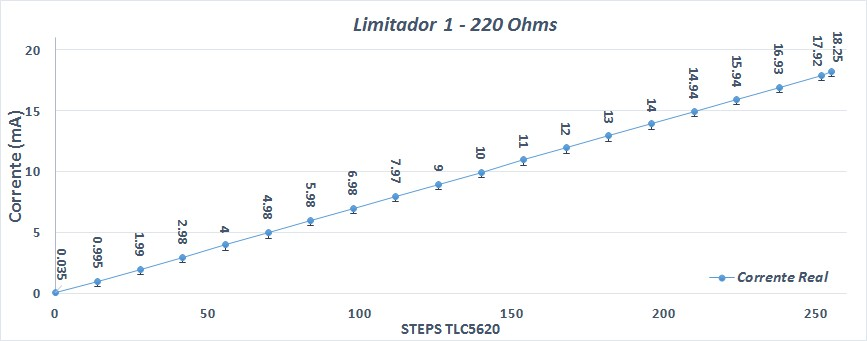
Photos/Graphics and presentation/220OHm current range.jpg
