YanOliveira00/Optical-Power-Meter/Photos/Graphics and presentation/680OHm current range.jpg

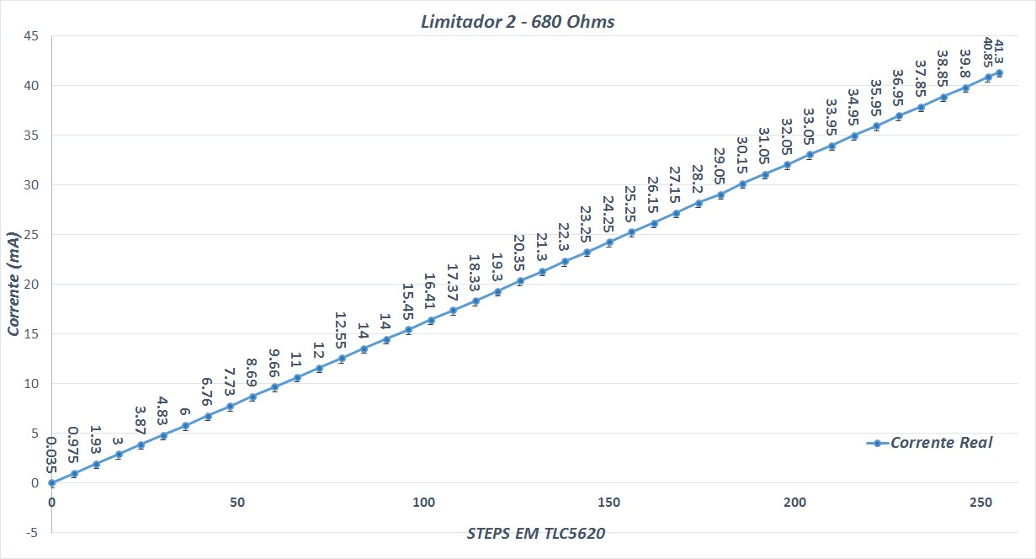
Photos/Graphics and presentation/680OHm current range.jpg
