YanOliveira00/Optical-Power-Meter/Photos/Tests and black box/06 Optical Fiber passing through the tube.jpg

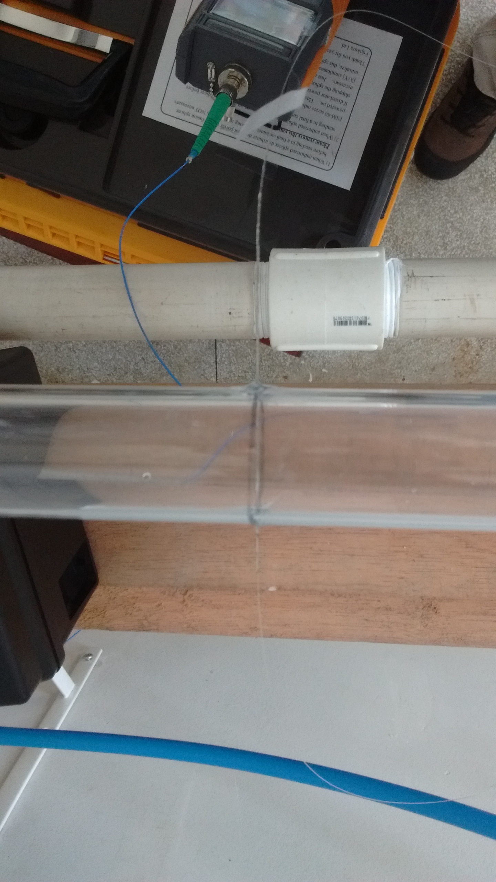
Photos/Tests and black box/06 Optical Fiber passing through the tube.jpg
