YanOliveira00/Optical-Power-Meter/Photos/Tests and black box/03 Outside the box.jpg

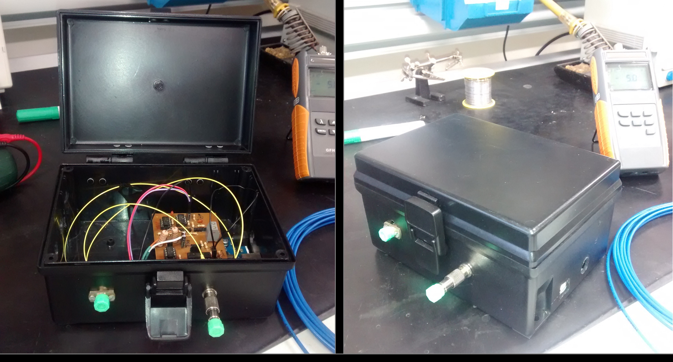
Photos/Tests and black box/03 Outside the box.jpg
