YanOliveira00/Optical-Power-Meter/Photos/Tests and black box/04 Second test.jpg

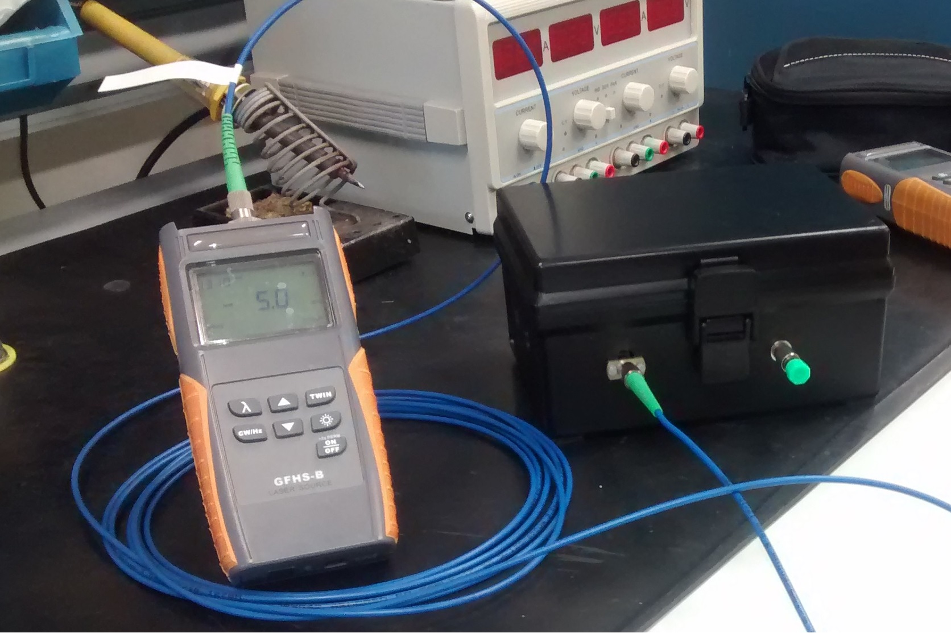
Photos/Tests and black box/04 Second test.jpg
