YanOliveira00/Optical-Power-Meter/Photos/Tests and black box/05 Final test.jpg

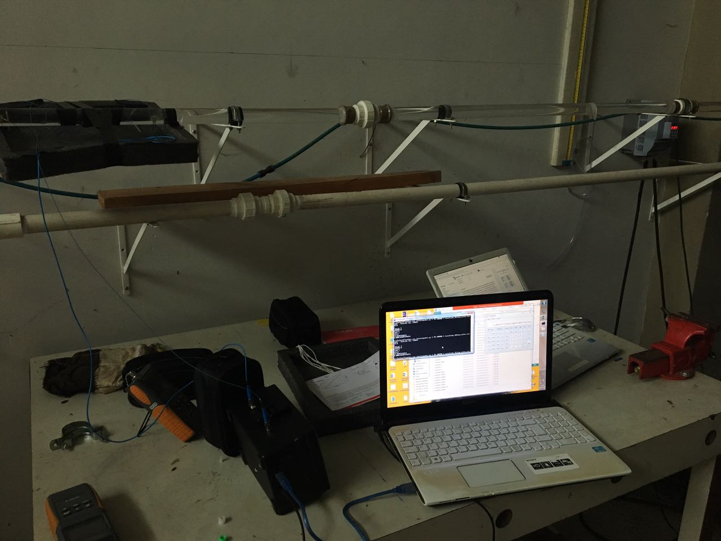
Photos/Tests and black box/05 Final test.jpg
