YanOliveira00/Optical-Power-Meter/interrogador20160804/imprimir 3 placas.pdf

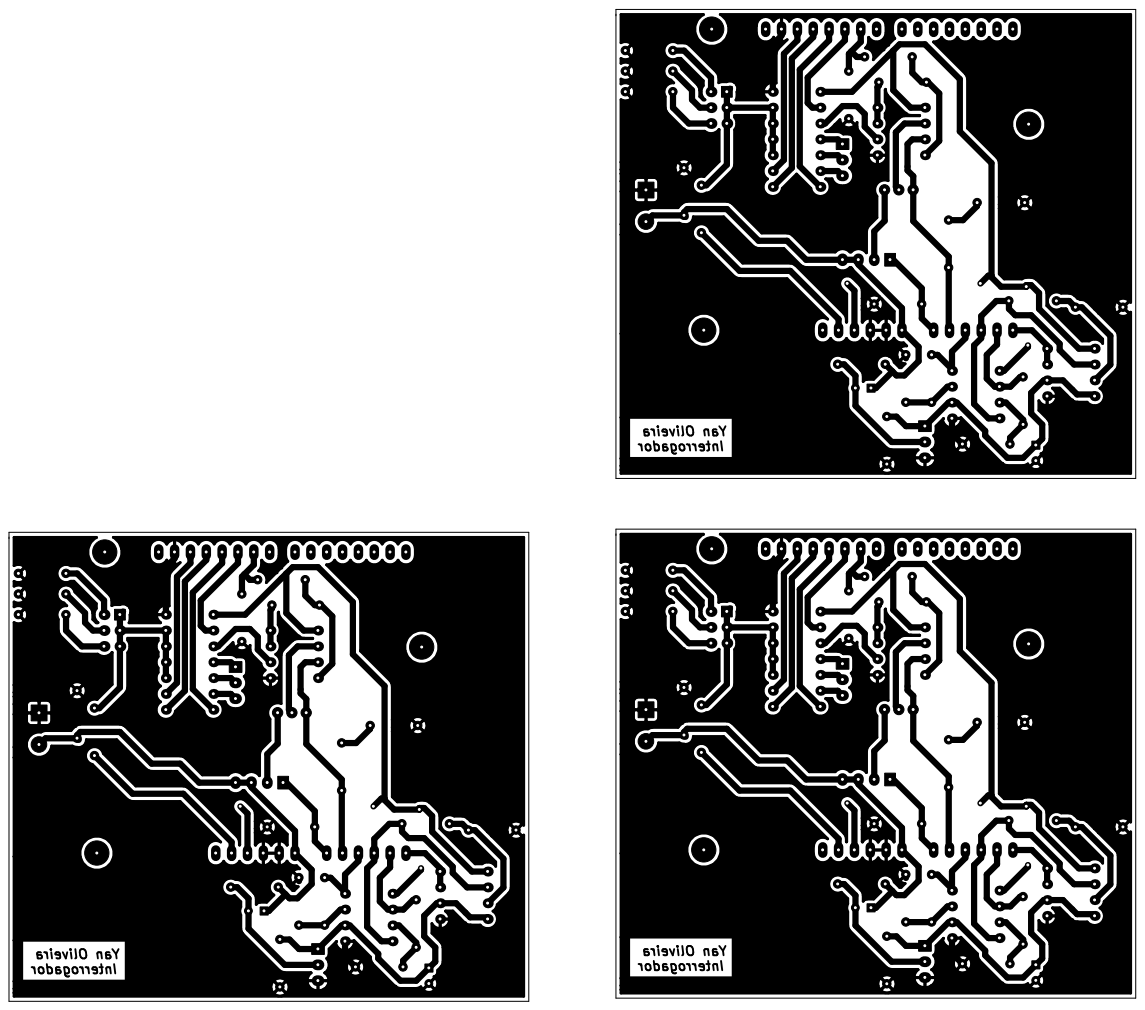
[picture p51: page 1]
