YanOliveira00/Optical-Power-Meter/interrogador20160804/kicad template.kicad_pcb

## KiCad design interrogador20160804/kicad template.kicad_pcb (2018-02-28)

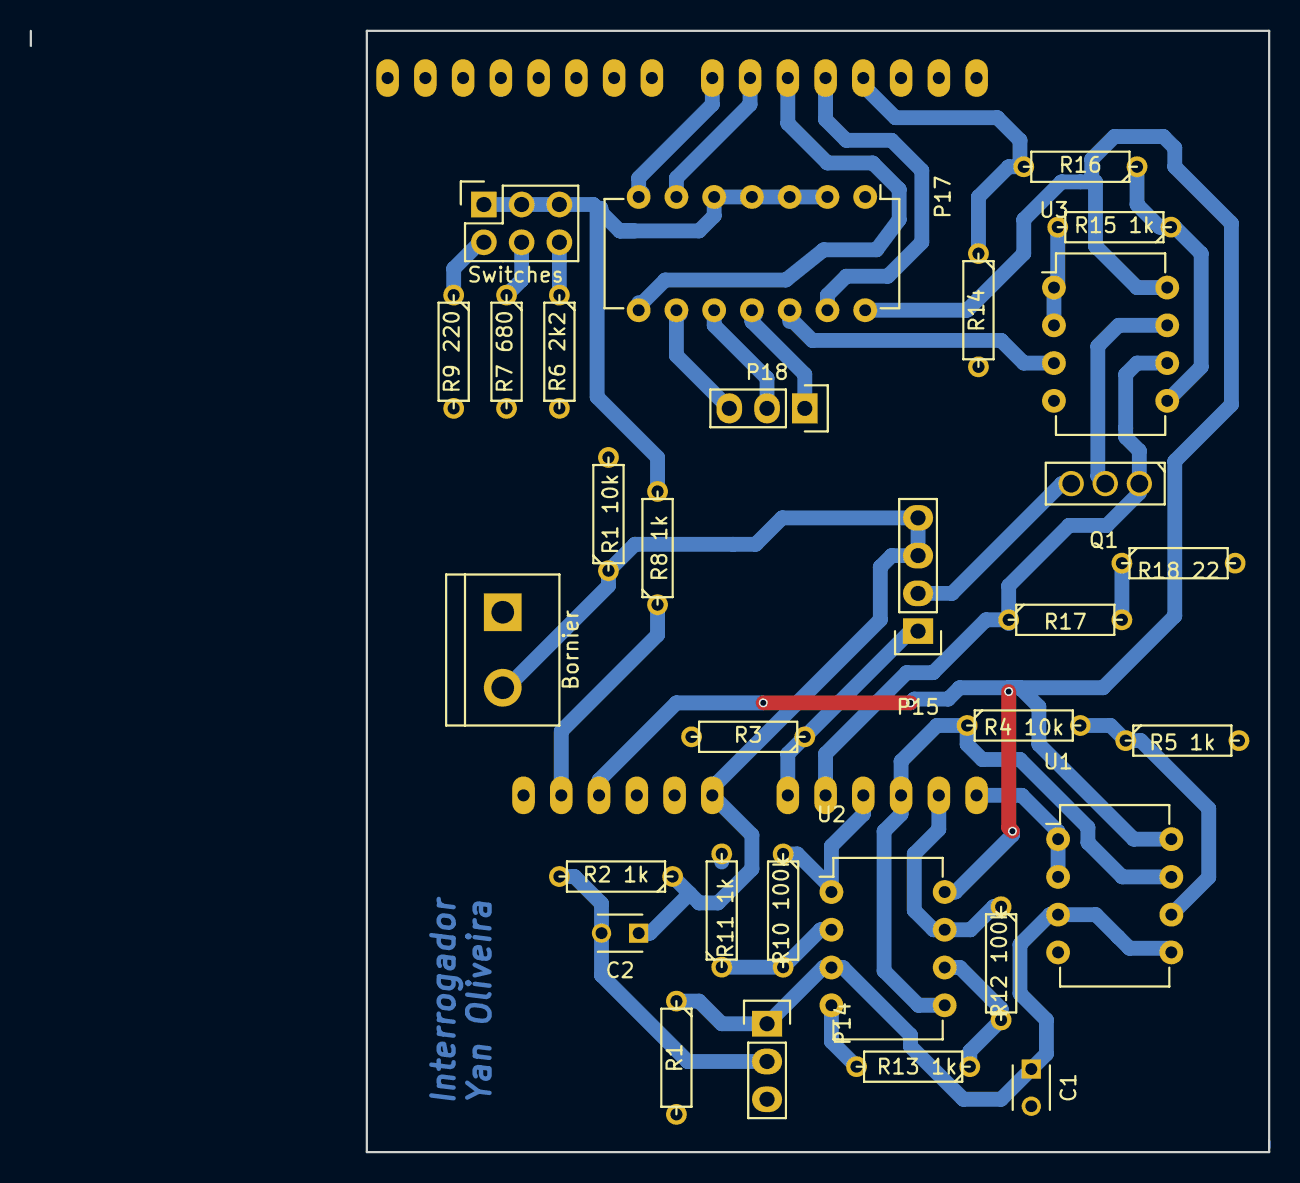
[picture p52: board kicad template.kicad_pcb from above]

Board: 2 copper layers, 83.3 x 75.4 mm, 32 parts (1 on the bottom side), 33 nets.

Parts:
Bornier: PowerIn; bornier2
C1: 100p; C_Disc_D3_P2.5
C2: 100n; C_Disc_D3_P2.5
P14: Detector; Socket_Strip_Straight_1x03
P15: laser (PD+LD); Pin_Header_Straight_1x04
P17: TLC5620; DIP-14_W7.62mm
P18: extout; Socket_Strip_Straight_1x03
Q1: Q_NPN_EBC; SOT126_SOT32_Housing_Vertical
R1, R1 10k, R3, R4 10k: 10k; R3
R2 1k, R5 1k, R8 1k, R11 1k, R13 1k, R15 1k: 1k; R3
R6 2k2: 2k2; R3
R7 680: 680; R3
R9 220: 220; R3
R10 100k, R12 100k, R14: 100k; R3
R16: 15k; R3
R17: 10; R3
R18 22: 22; R3
SHIELD1: ARDUINO_SHIELD
Switches: CONN_02X03; Socket_Strip_Straight_2x03
U1, U2, U3: MCP6002; DIP-8_W7.62mm

Connections:
+3V3: R8 1k.1, SHIELD1.3V3
+5V: P17.14, SHIELD1.5V, U1.8, U2.8, U3.8
/1X: SHIELD1.AD5, U1.1, U1.2
/10X: R4 10k.1, SHIELD1.AD3, U1.7, U2.5
/100X: R10 100k.1, SHIELD1.AD2, U2.1
/1000X: R12 100k.1, SHIELD1.AD4, U2.7
/AMPFEED: Q1.1, R17.1, SHIELD1.AD1, U3.6
/CLK: P17.7, SHIELD1.7
/DAC_A: R15 1k.2, U3.1, U3.2
/DATA: P17.6, SHIELD1.6
/LD: P15.2, Q1.3
/LDAC: P17.13, SHIELD1.4
/LOAD: P17.8, SHIELD1.5
/MOD: R14.1, R16.2, SHIELD1.3
/PD: P15.1, R3.1, SHIELD1.AD0
/input: C1.1, P14.1, R1.1, U1.3, U1.5, U2.3
GND: Bornier.1, C1.2, P14.3, P17.1, R1.2, R1 10k.2, R3.2, R5 1k.2, R6 2k2.2, R7 680.2, R9 220.2, R11 1k.2, R13 1k.2, R14.2, R18 22.2, SHIELD1.GND1, SHIELD1.GND2, SHIELD1.GND3, U1.4, U2.4, U3.4
unnamed: C2.2, P14.2, R2 1k.2
unnamed: P17.2, P17.3, P17.4, P17.5, R8 1k.2, Switches.1, Switches.3, Switches.5
unnamed: R9 220.1, Switches.2
unnamed: R7 680.1, Switches.4
unnamed: R6 2k2.1, Switches.6
unnamed: P17.9, P18.3
unnamed: P17.10, P18.2
unnamed: P17.11, P18.1
unnamed: P17.12, U3.3
unnamed: Q1.2, U3.7
unnamed: R4 10k.2, R5 1k.1, U1.6
unnamed: R10 100k.2, R11 1k.1, U2.2
unnamed: R12 100k.2, R13 1k.1, U2.6
unnamed: R15 1k.1, R16.1, U3.5
unnamed: R17.2, R18 22.1
VCC: Bornier.2, C2.1, P15.3, P15.4, R1 10k.1, R2 1k.1, SHIELD1.V_IN
