YanOliveira00/Optical-Power-Meter/(commit log)

2018-02-28 Adicionando um readme para o código python.
2018-02-28 Adding readmes for python and arduino (C++) codes. All of it is in Pt-br.
